archlab-sciencetokyo/robbit_project/robbit/setting/image/display-sim.png

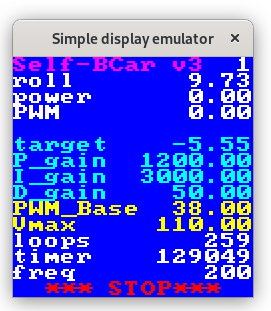
robbit/setting/image/display-sim.png
