archlab-sciencetokyo/robbit_project/robbit-esp/manual/robbit-esp_manual.pdf

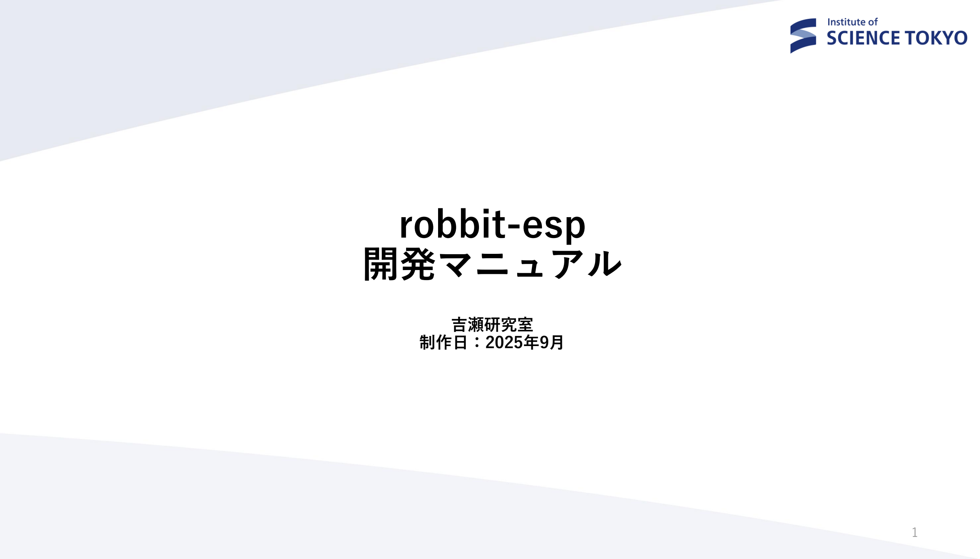
[picture p7: page 1]

## robbit-esp 開発マニュアル

吉瀬研究室
制作日：2025年9月

## robbit-esp : 概要

◼ robbit-espはESP32-C3で制御する扱いやすいtwo-wheeled self-balancing robotである。

◼ 開発手順
robbit-espの組み立て

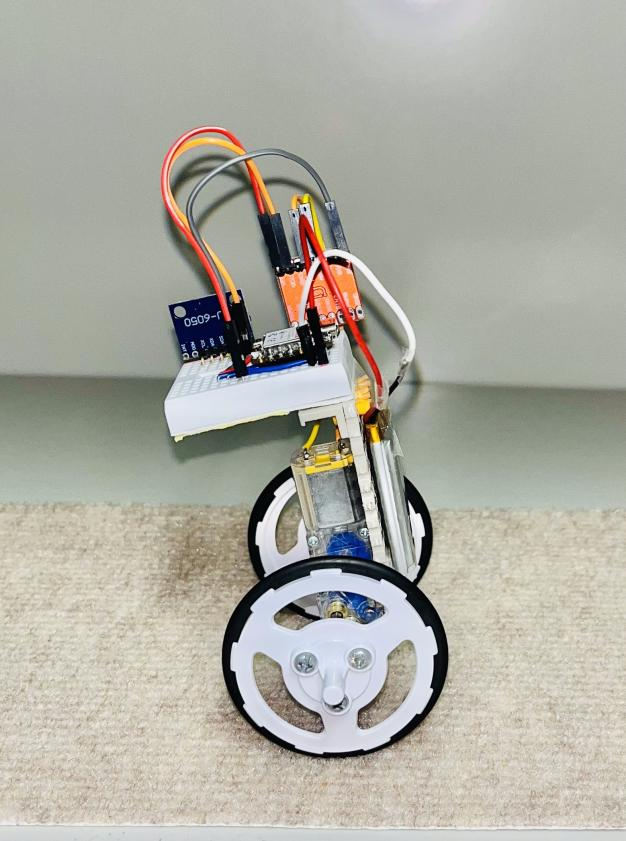
[picture p8: figure]
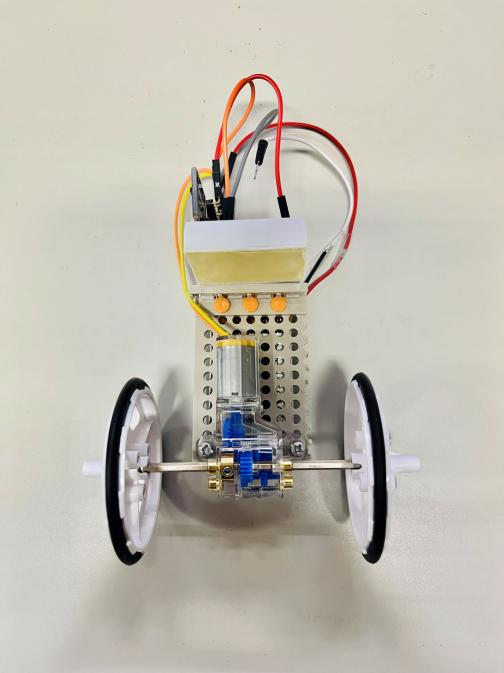
[picture p9: figure]

プログラム書き込み

動作確認

パラメータチューニング

robbit-esp

## robbit-espの組み立て : 部品購入

◼ robbit-espの組み立ては以下の手順で行う

部品購入 | シャーシ作成 | 制御ユニット作成 | 接着

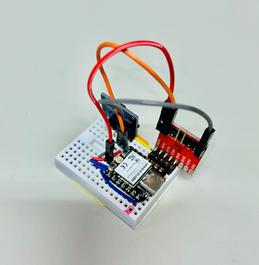
[picture p10: figure]
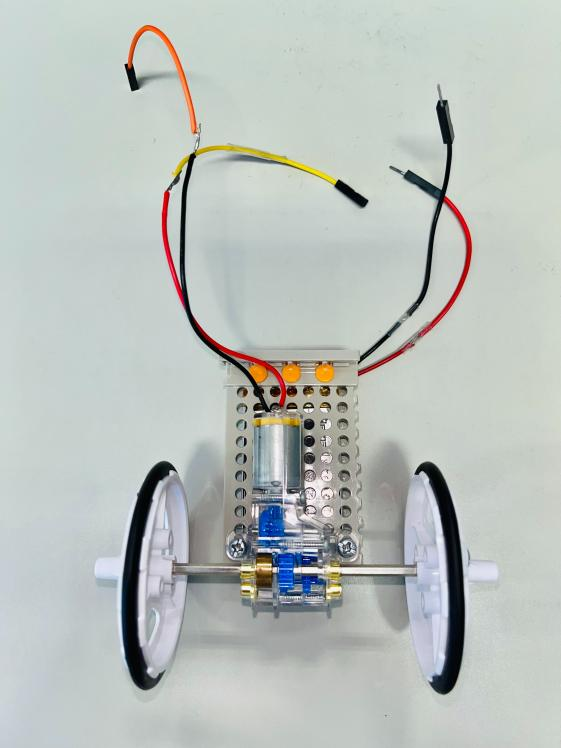
[picture p11: figure]

## robbit-espの組み立て : 部品購入

◼ 下記の部品一覧にある部品を購入する

部品 | 名称 | 個数
マイクロコントローラ | XIAO ESP32-C3 | 1
センサ | MPU-6050 | 1
モータ | Mini Motor Standard Gearbox 70188 | 1
タイヤ | Slim Tire Set (55mm Dia.) 70193 | 1
モータドライバ | TB6612FNG | 1
バッテリー | EEMB Lithium-Ion Battery 653042 | 1
プレート | Universal Plate Set 70157 | 1

## robbit-espの組み立て : シャーシ作成

◼ バッテリーと電源モジュールを図のようにはんだ付けする ◼ はんだ付け後は、バッテリーを充電モジュールに接続する ◼ 充電モジュールの色でバッテリーの充電具合がわかる (赤: 充電不足, 青: 充電完了)

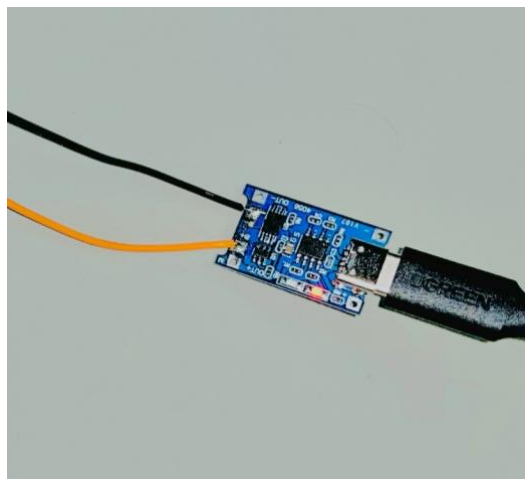
[picture p12: figure]
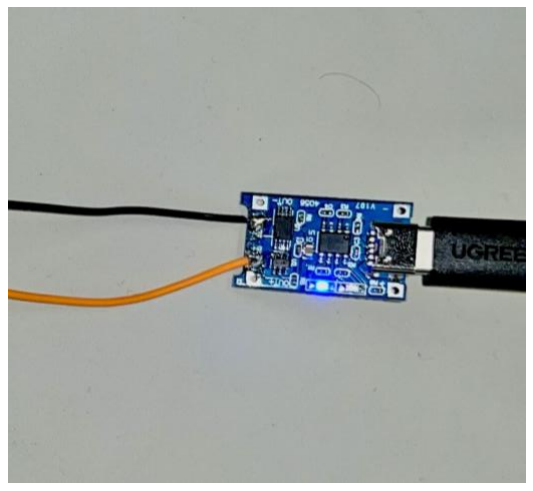
[picture p13: figure]

赤: 充電不足 | 青: 充電完了

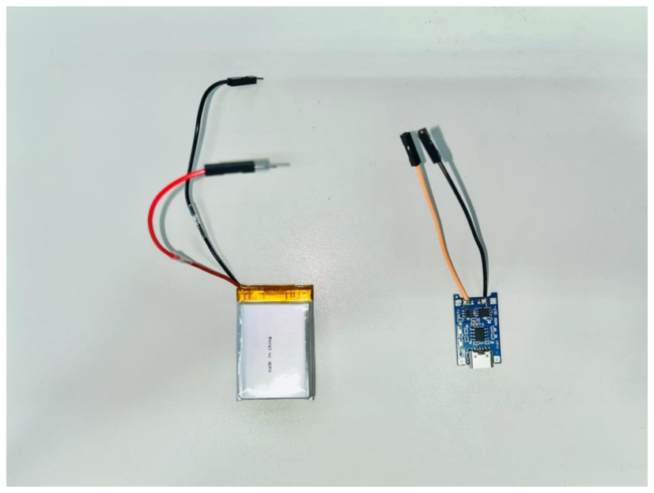
[picture p14: figure]

はんだ付けの例 | 充電モジュールのLED点灯

## robbit-espの組み立て : シャーシ作成

◼ ユニバーサルプレートをはんだ付けする
◼ ユニバーサルプレートはこの後作る制御ユニットの大きさに合わせるとよい ◼ またユニバーサルプレートには下図のように、制御ユニットを接着する部分を用 意しておく

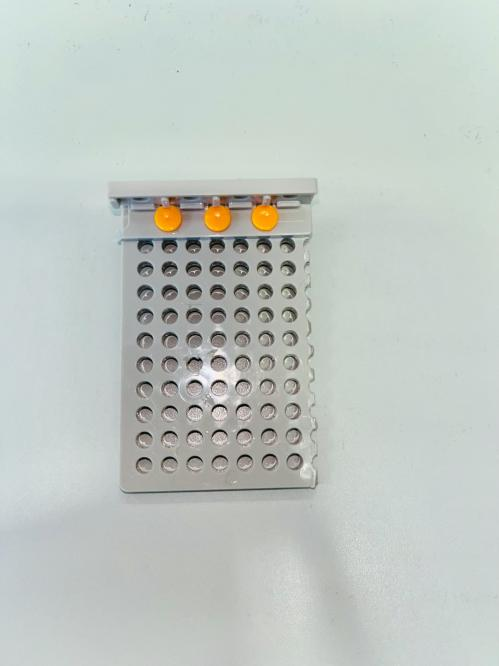
[picture p15: figure]
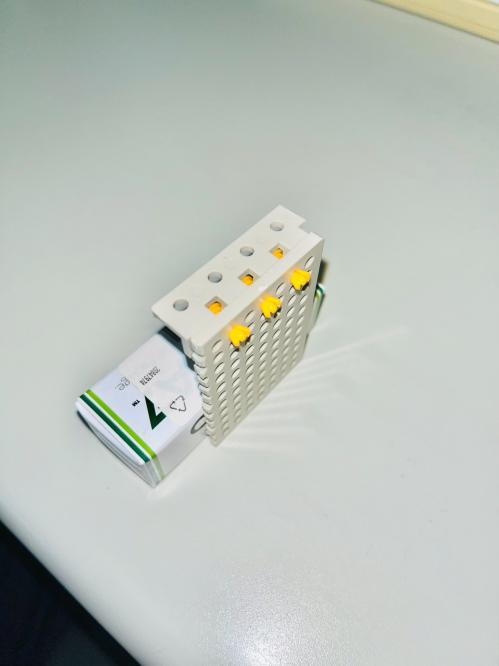
[picture p16: figure]

切断後のユニバーサルプレート | 制御ユニットとの接続部分 | 6

## robbit-espの組み立て : シャーシ作成

◼ TAMIYAのMini Motor Standard Gearbox 70188とSlim Tire Set (55mm Dia.) 70193を作成する。

◼ 次ページにギアボックス組み立てマニュアルを載せている。必要な部品や作業に は黄色で色付けしている

◼ タイヤに関しては、最初は直径が55mmのタイヤを使用すると良い。 直径が小さいタイヤも同封されているが、制御が難しくなる場合がある。

## robbit-espの組み立て : シャーシ作成

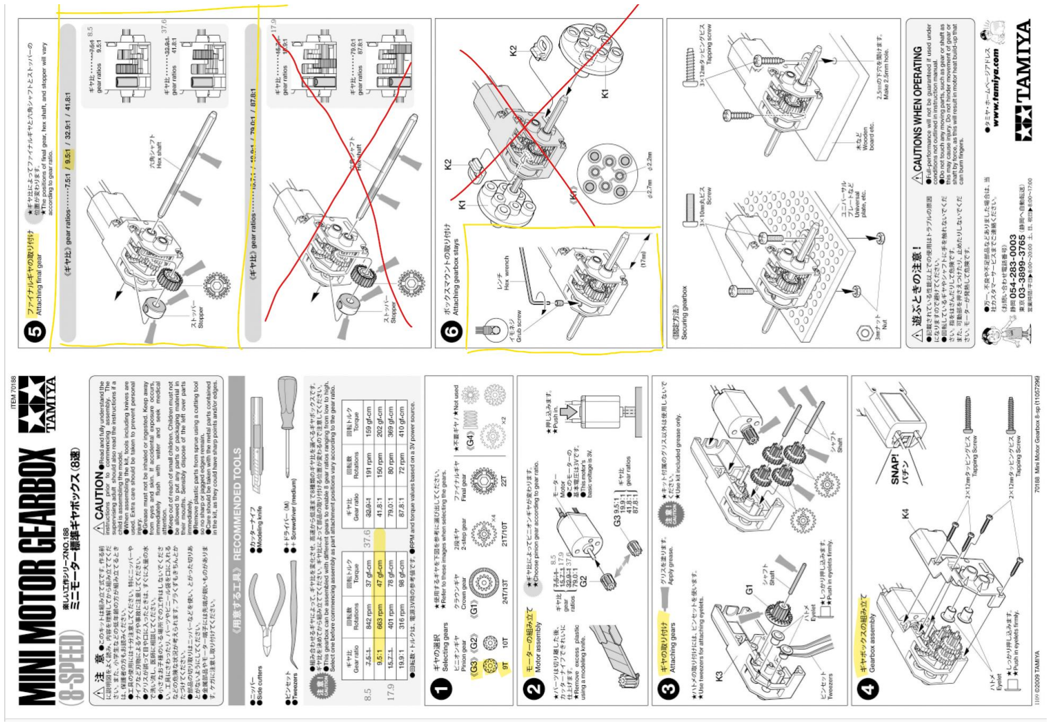
[picture p17: figure]

## robbit-espの組み立て : シャーシ作成

◼ モータが完成したらタイヤを取り付ける
◼ 最後にユニバーサルプレートにバッテリーとモータを取り付けるとシャーシが完 成する。

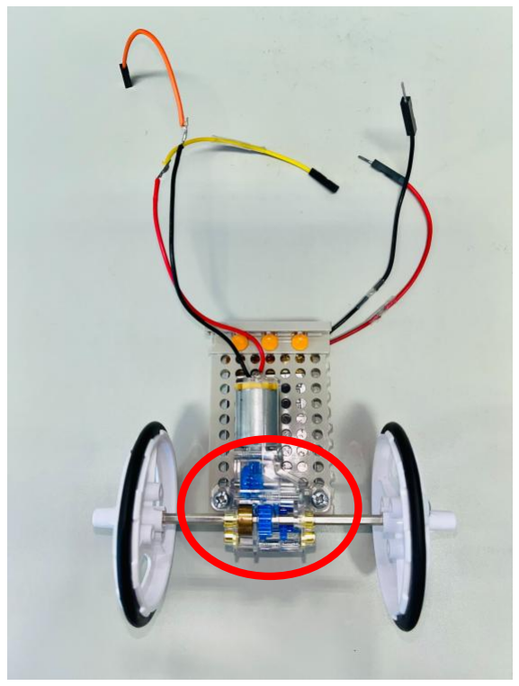
[picture p18: figure]
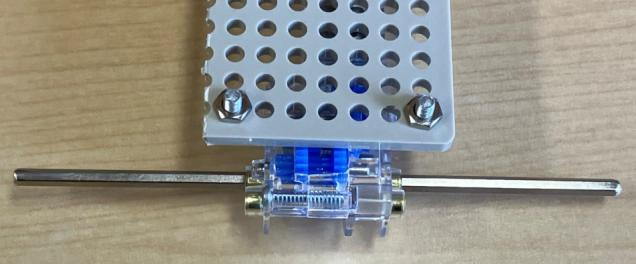
[picture p19: figure]

シャーシの完成例 | 9

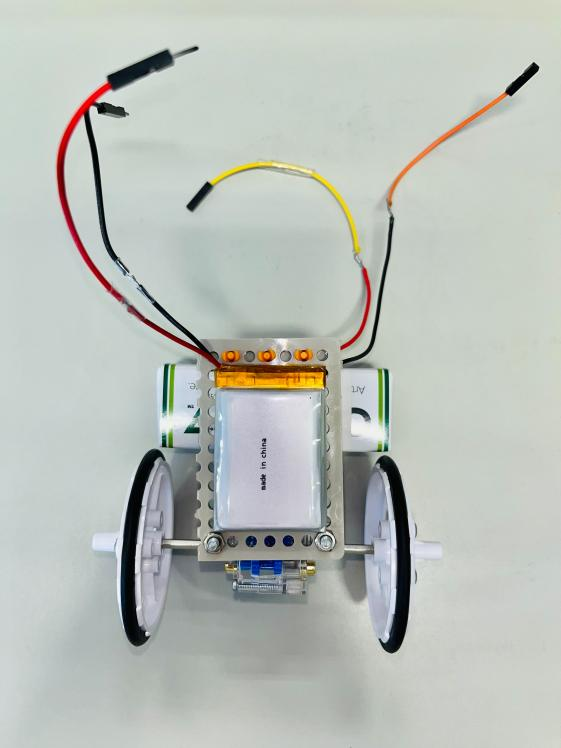
[picture p20: figure]

ネジでしっかり固定

## robbit-espの組み立て : 制御ユニット作成

◼ センサ(MPU-6050)にピンヘッダをはんだ付けする。 IMUモジュールはVCC, GND, SCL, SDAをつなげば動作するが，安定性向上のため接続部分にはすべて ヘッダピンをはんだ付けすることを勧める。

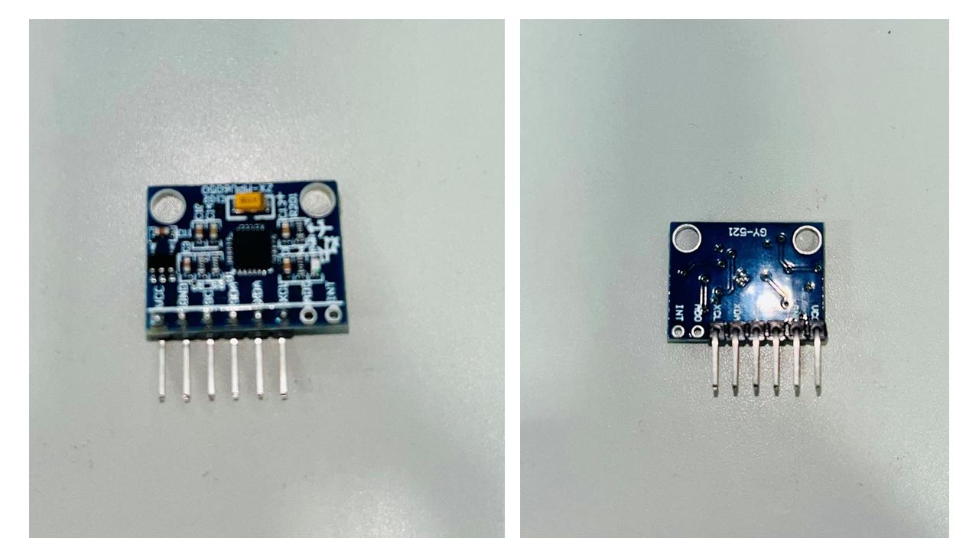
[picture p21: figure]
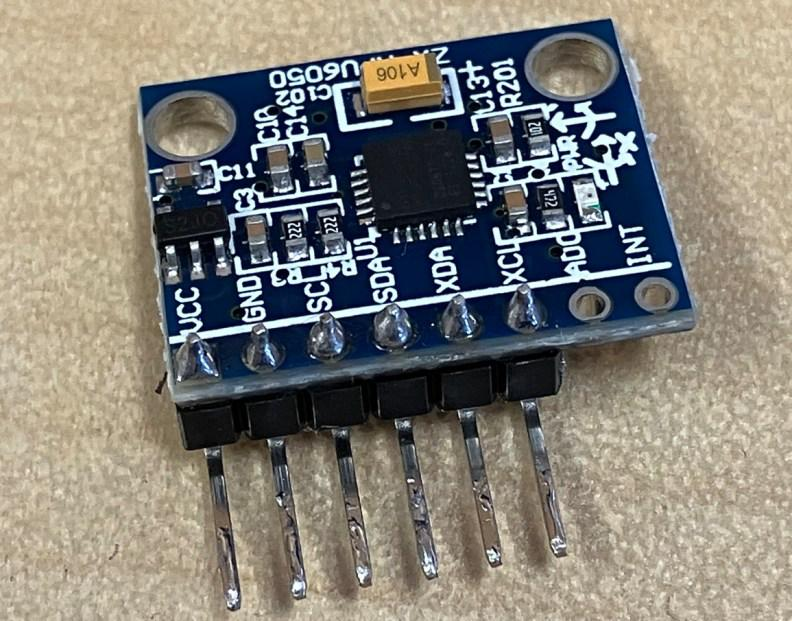
[picture p22: figure]

はんだ付けの例 | 10

## robbit-espの組み立て : 制御ユニット作成

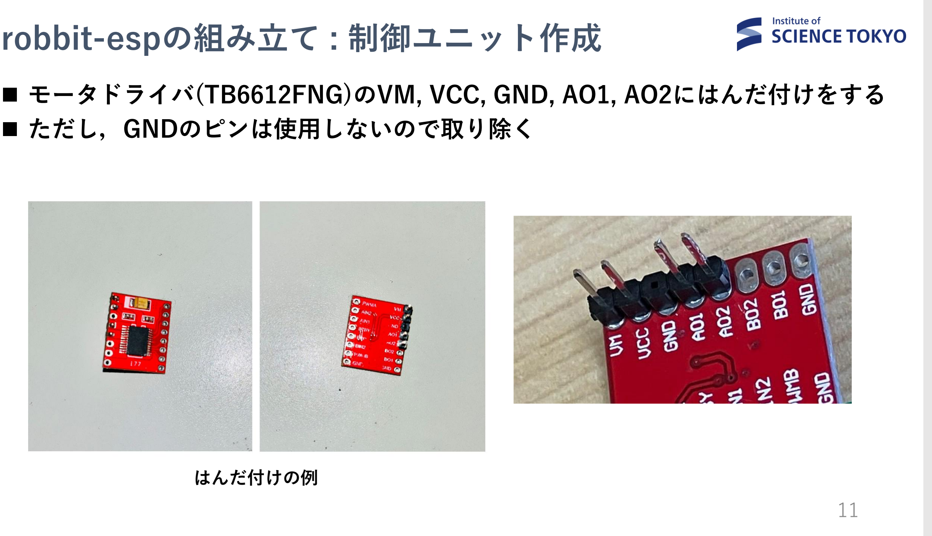
[picture p23: page 11]

◼ モータドライバ(TB6612FNG)のVM, VCC, GND, AO1, AO2にはんだ付けをする ◼ ただし，GNDのピンは使用しないので取り除く

はんだ付けの例

## robbit-espの組み立て : 制御ユニット作成

◼ ブレッドボードまたは、ユニバーサル基板を用意する。
◼ 用意したブレッドボードまたは基板に回路図を参考に配線、はんだ付けをする。

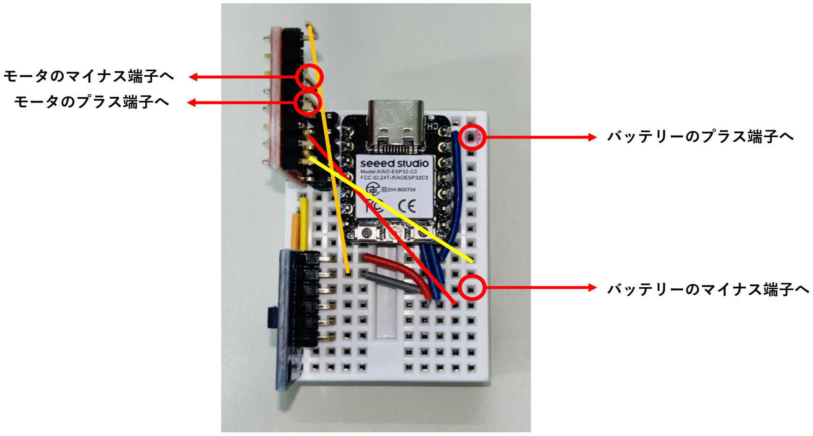
[picture p24: figure]
バッテリーのプラス端子へ; バッテリーのマイナス端子へ; モータのマイナス端子へ; モータのプラス端子へ
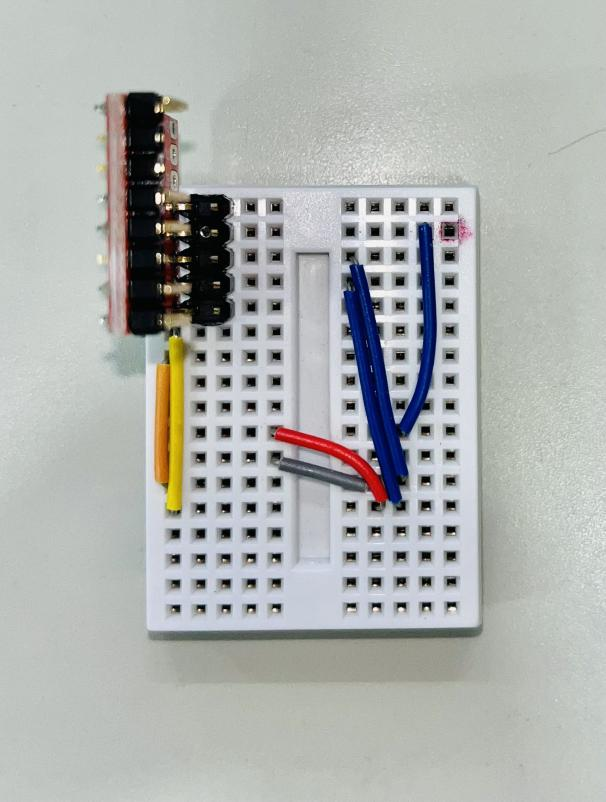
[picture p25: figure]

## robbit-espの組み立て : 制御ユニット作成

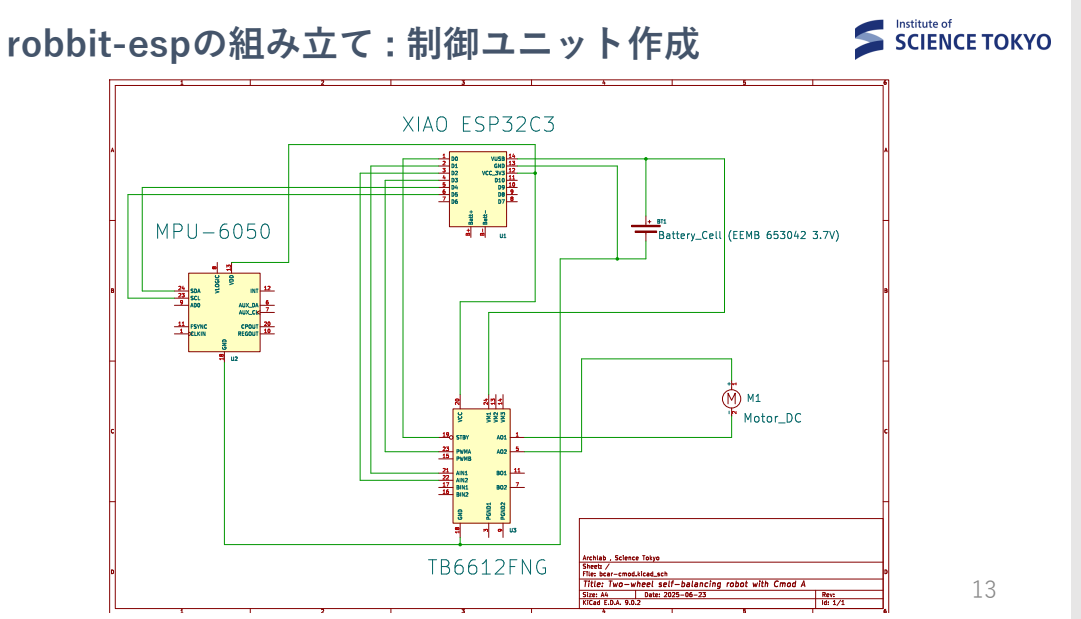
[picture p26: page 13]

## robbit-espの組み立て : 制御ユニット作成

◼ 完成したシャーシと制御ユニットを両面テープ等で接着すると、robbit-espが完 成する。

接着

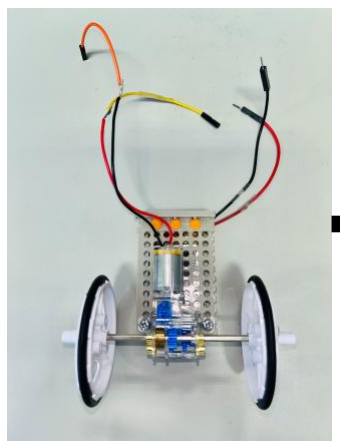
[picture p27: figure]

シャーシ

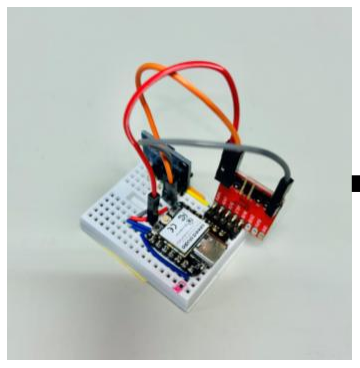
[picture p28: figure]

制御ユニット

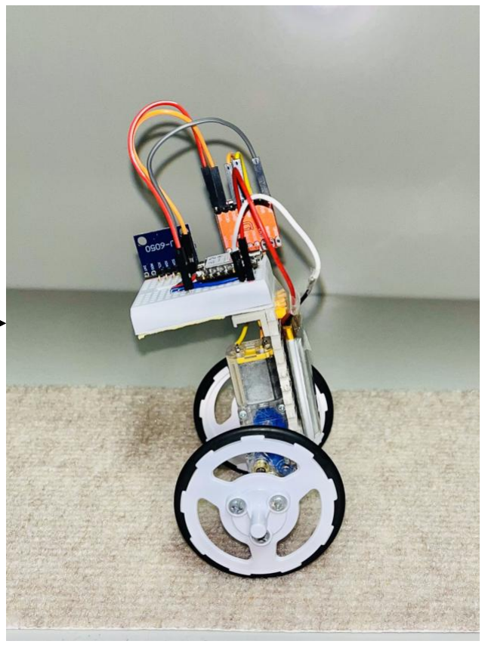
[picture p29: figure]

robbit-esp

## プログラム書き込み: 環境構築

◼ 完成したrobbit-espにプログラムを書き込むにはArduino IDEを使用する ダウンロードしていない場合はダウンロードする

◼ ダウンロードページ: https://www.arduino.cc/en/software/

◼ Arduino IDEのダウンロードが完了したら、githubのリポジトリにあるrobbit-esp.inoを開き、各種設定を行う。

## プログラム書き込み: ボード設定

◼ `File` -> `Preferences` -> `Setting` -> `Additional boards manager URLs` に以下のURLを設定する
https://raw.githubusercontent.com/espressif/arduino-esp32/gh-pages/package_esp32_index.json

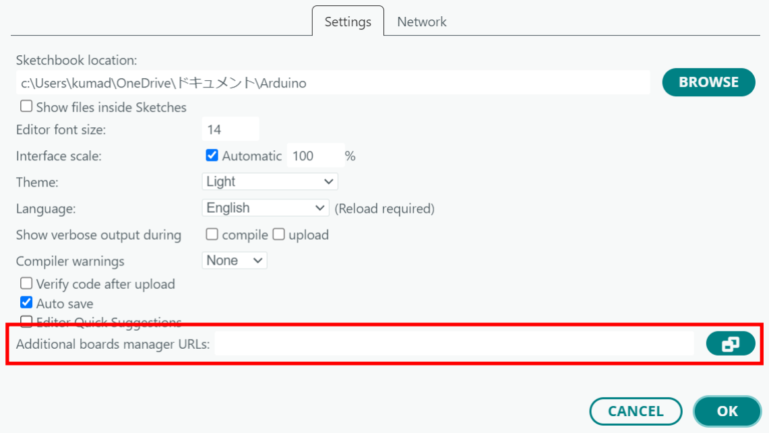
[picture p30: figure]

URLの記入場所

## プログラム書き込み: ボード設定

◼ `Tools` -> `Board` -> `Board Manager`でBoard Managerを開き `esp32 by Espressif Systems`をダウンロードする
◼ `Tools` -> `Board` -> `esp32` -> `XIAO_ESP32C3` を選択する
◼ `Tools` -> `Port` でESP32-C3に対応するポート番号を設定する

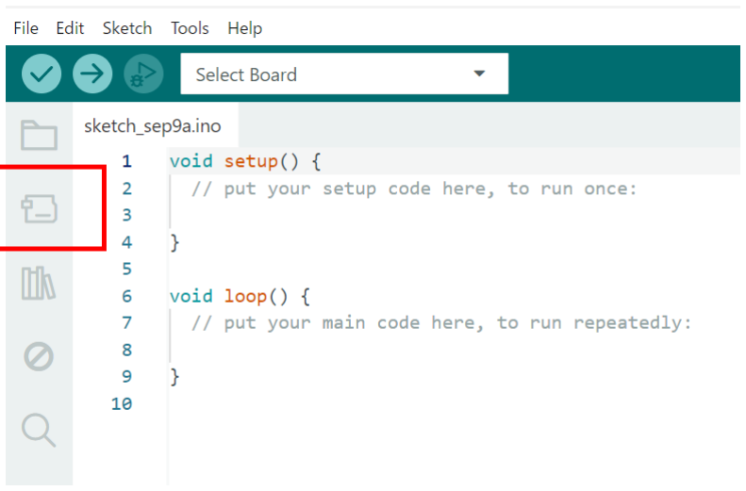
[picture p31: figure]

ここからもボードマ
ネージャーを開ける

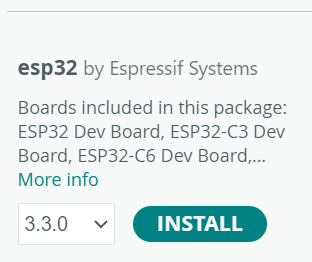
[picture p32: figure]

インストールするボード

## プログラム書き込み: ライブラリ設定

◼ `Tools` -> `Manage libraries`でライブラリマネージャーを開き以下のライブ ラリをインストールする

- MPU6050 by Electric Cats
- Madgwick by Arduino
- BluetoothSerial by Henry Abrahamsen

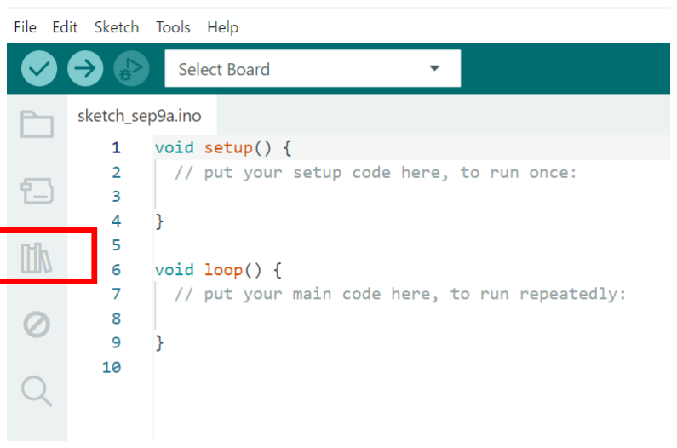
[picture p33: figure]

◼ Madgwickフィルタのライブラリ内にMadgwickAHRS.hというヘッダーファイ ルがあるので以下の関数を追加する

void setGain(float gain) { beta = gain; }

ここからもライブラリ
マネージャーを開ける

## プログラム書き込み: 書き込み

◼ 書き込む前に以下のことを確認する
- PCとESP32-C3が接続する
- `Tools` -> `Port` でESP32-C3に対応するポート番号を設定する
- `Tools` -> `Board` -> `esp32` -> `XIAO_ESP32C3` を選択する

◼ 上記の内容をすべて確認出来たら画面左上のUploadマークを押すとコンパイルが 行われた後、書き込みが行われる。

Uploadボタン

## 動作確認

◼ 書き込みが終了したら、PCとESP32-C3の接続を解除し、robbit-espの電源を入 れて動作を確認する。
◼ 動作確認はカーペットのようなある程度摩擦が生じる環境で行うと良い。
◼ 摩擦のない環境だと、その場で自立することが難しくなる。

動作確認の項目
◼ 手にもって、robbit-espを傾けた時に傾けた方向に車輪が回転するか
◼ 垂直状態から90度傾けた時に車輪の動きが止まるか(プログラムでは40度傾くと 止まるようになっている)

## パラメータチューニング: 環境構築

◼ robbit-espはPCやスマートフォンとのBLE通信によりパラメータチューニングを 行える。

◼ PCの場合
- パラメータチューニングにはpythonライブラリのbleakを使用するため、仮想環 境を作成する必要がある
- Pythonの仮想環境を作成した後、pip install bleakを実行しインストールを行う -> 22ページへ
◼ スマートフォンの場合
- BLE通信を行う専用のアプリをインストールする -> 25ページへ

BLE Scanner(Android, iOS両方に対応)

## パラメータチューニング: BLE接続(PC)

◼ robbit-espを起動し、少し待ってからble_connect.pyを実行する。
◼ 実行すると、robbit-espとPCの無線での接続が行われ、成功すると下記の画面が 出力される。
◼ この画面では，robbitに搭載するESP32-C3のサービスUUID(Service_uuid)、 MACアドレス(MAC_adress)、Characteristic_uuidを表示している。
◼ Service_uuidとCharacteristic_uuidはinoファイルの冒頭で定義している値に なっているはずである。

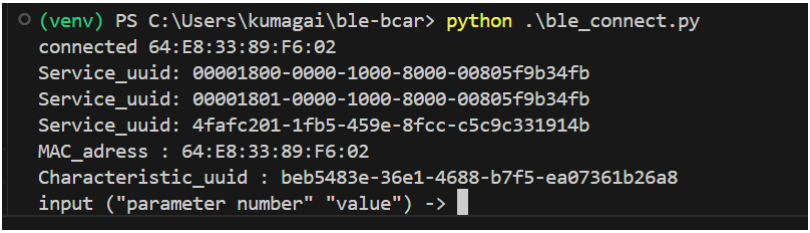
[picture p34: figure]

## パラメータチューニング: 値変更(PC)

◼ パラメータの変更は`input (“parameter number” “value”) -> `の後に以下のよ うな形式で入力すると実行される。パラメータ番号については28ページ参照

"パラメータ番号"␣"値"
ただし、␣は半角スペース

◼ 下の画像はV_MAXというパラメータを200に変更した場合の例である。 変更が完了すると、変更結果が出力される

## パラメータチューニング: その他の命令

◼ 現状のパラメータを確認したい場合は、`input ("parameter number" "value") -> `に`r`を入力すると確認できる。

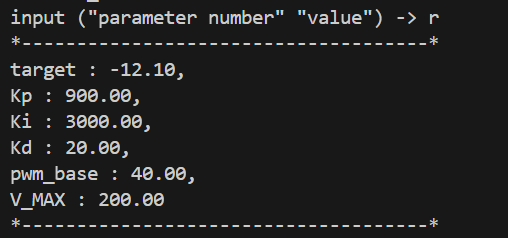
[picture p35: figure]

◼ robbit-espとのBLE接続を解除する場合には，`input (“parameter number” “value”) -> `に`e`を入力すると解除できる。

## パラメータチューニング: BLE接続(スマホ)

◼ robbit-espを起動すると、BLE Scannerの画面 にESP32-C3の接続先が現れる
◼ 接続端末の名前はinoファイル内の以下の部分で
設定している
◼ 同時に複数のrobbit-espを動かす際には、それぞ れ接続端末の名前を変更することを勧める

接続端末の名前設定

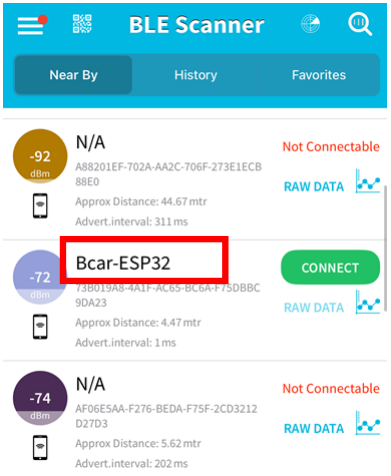
[picture p36: figure]

アプリの画面

## パラメータチューニング: 値変更(スマホ)

◼ パラメータの変更は以下のような形式で入力すると実行される。 パラメータ番号については28ページ参照

"パラメータ番号"␣"値"
ただし、␣は半角スペース

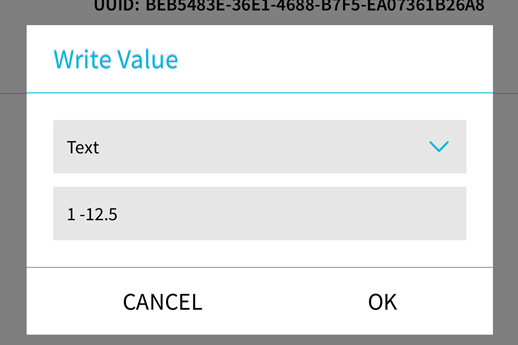
[picture p37: figure]

入力例

## パラメータチューニング: その他の命令

◼ アプリ内でread処理を行うことですべてのパラメータを確認できる ◼ 表示形式はカンマ区切りで以下のように出力される。 TARGET, P_GAIN, I_GAIN, D_GAIN, PWM_Base, V_MAX

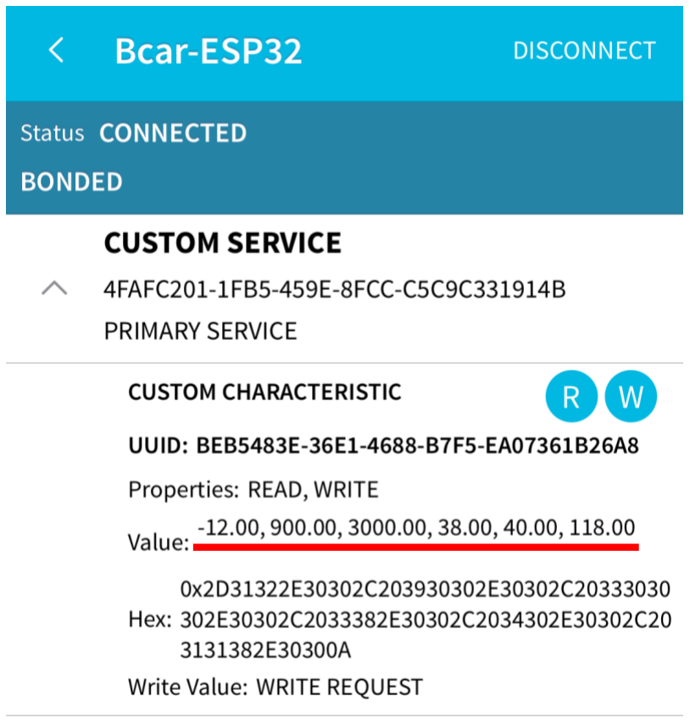
[picture p38: figure]

パラメーター値

## パラメータチューニング: パラメータ番号

◼ パラメータチューニングの際に利用するパラメータ番号とは、変更可能なパラ メータに割り当てられている番号である

パラメータ名 | パラメータ番号 | 役割
Target | 1 | 車体の目標角度
P_gain | 2 | 比例要素のゲイン
I_gain | 3 | 積分要素のゲイン
D_gain | 4 | 微分要素のゲイン
PWM_Base | 5 | PWM信号の増加値
V_max | 6 | PWM信号の最大値

## パラメータチューニング: その他のパラメータ

- ループ周波数
ループ周波数とはrobbit-esp.ino内に記述されているwhileループの周波数を表す robbit-esp.ino内の``D_LOOP_HZ`がループ周波数を表す 値を大きくすればその分whileループ内の処理も高速に行われる 単位はHzで記述する
- 積分要素の上限値
アンチワインドアップ実装のため，積分要素の上限値を決定する robbit-esp.inoの`D_I_MAX`に値が設定してある

500Hzに設定した例

上限値を0.2に設定した例

## 問題設定

パラメータチューニングの際にどの程度まで性能向上を目指すか、目標を考える 下記は一例である

◼ 難易度：易しい
カーペットなどの摩擦のある領域で10分以上の自立を目指す

◼ 難易度：難しい
摩擦の少ない領域でできるだけ長く自立させる
風や傾斜などの外乱を加える
