archlab-sciencetokyo/robbit_project/robbit-esp/manual/robbit-esp_system_manual.pdf

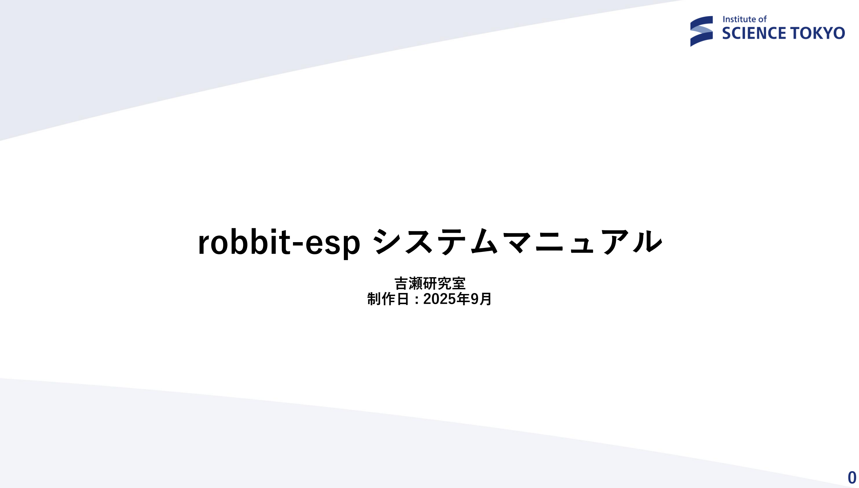
[picture p45: page 1]

## robbit-esp システムマニュアル

0

吉瀬研究室
制作日 : 2025年9月

概要

◼ このプログラムはrobbit-espのハードウェア，ソフトウェアの内容を説明してい る

◼ この資料を参考にすることで，robbit-espのシステムの理解が容易になり，性能 改善を行いやすくなる

1

## robbit-esp : ハードウェア

2

◼ マイコンボード: XIAO ESP32-C3
◼ センサ: MPU-6050(IMU)
- 加速度，角速度(ジャイロ)センサ
◼ ギアモータ: ミニモータ標準ギヤボックス(TAMIYA)

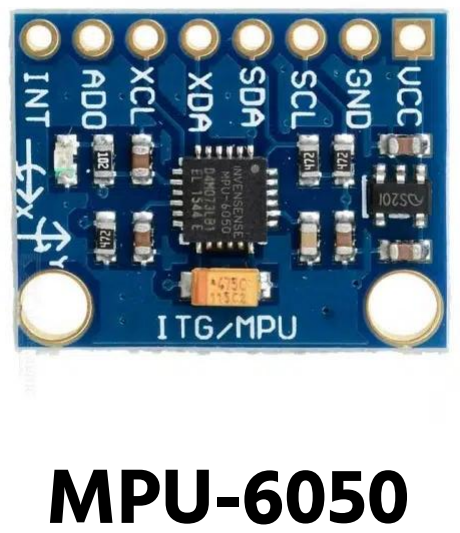
[picture p46: figure]
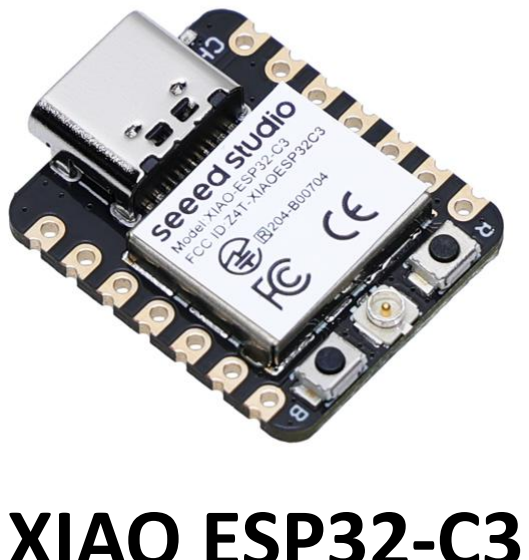
[picture p47: figure]
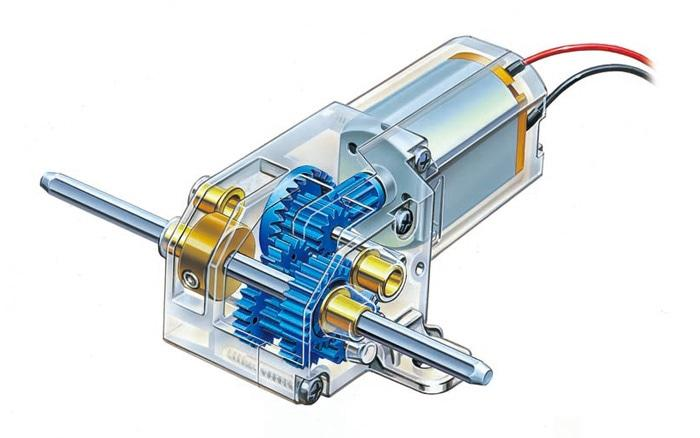
[picture p48: figure]

XIAO ESP32-C3 | MPU-6050 | ミニモータ標準ギヤボックス(TAMIYA)

## robbit-esp : ハードウェア

3

◼ モータドライバ: TB6612FNG搭載 モータドライバ ◼ タイヤ:スリムタイヤセット(55mm 径) 70193 ◼ バッテリー: EEMB 653042(3.7V)

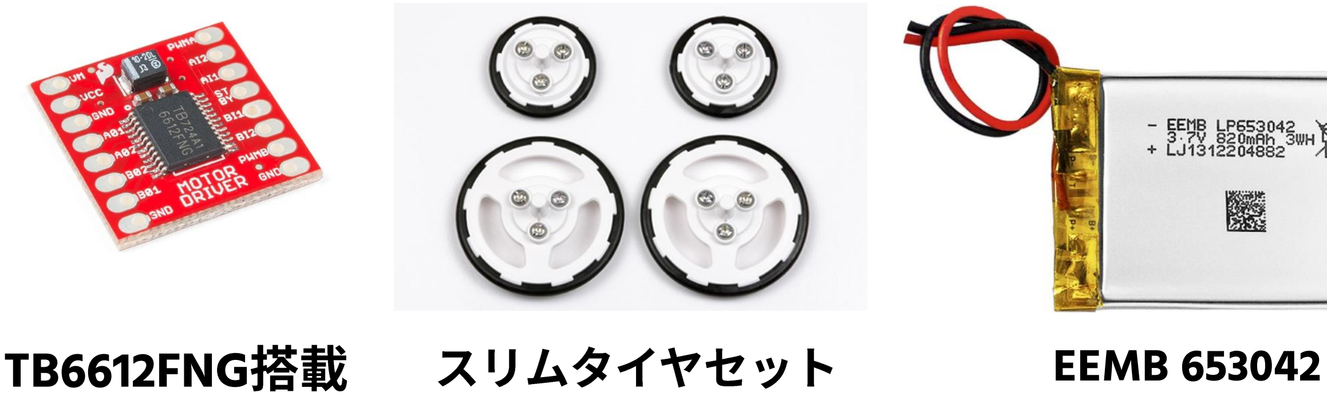
[picture p49: figure]
TB6612FNG搭載; スリムタイヤセット; EEMB 653042

モータドライバ

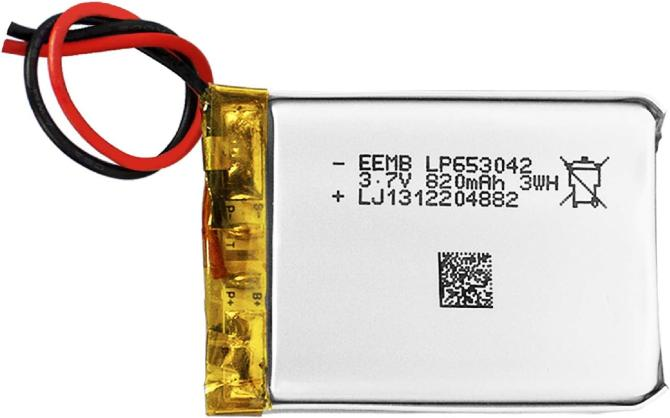
[picture p50: figure]

充電式バッテリー

## ソフトウェア: 概要

ソフトウェア処理はrobbit-esp.inoに書いてある。以下にフローチャートを示す。

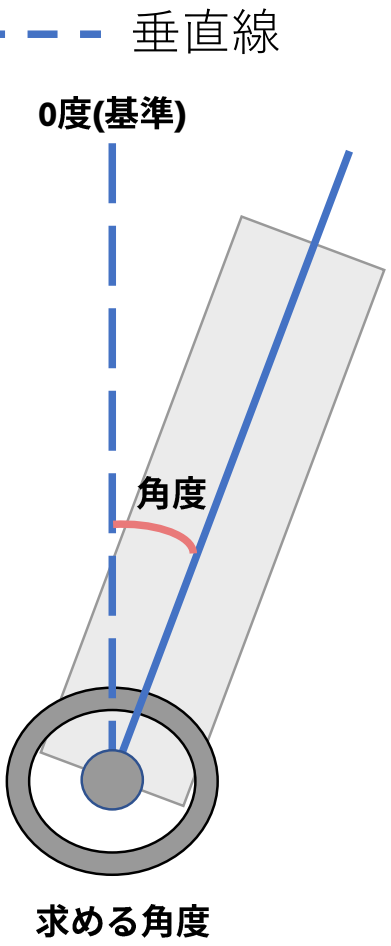
[picture p51: figure]
垂直線; 求める角度

4

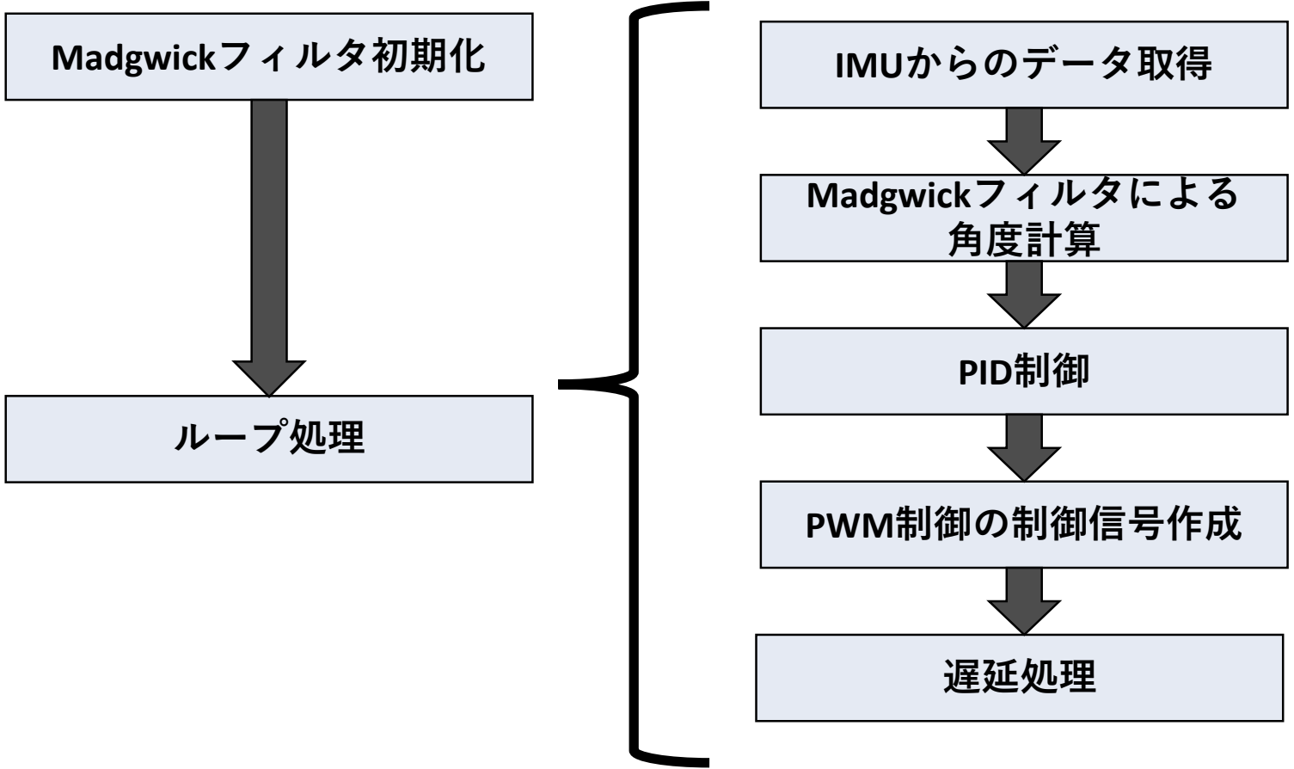
[picture p52: figure]
Madgwickフィルタ初期化; IMUからのデータ取得; Madgwickフィルタによる 角度計算; PID制御; PWM制御の制御信号作成; 遅延処理; ループ処理

## ソフトウェア: IMUからのデータ取得

◼ IMUから3軸の加速度と角速度を取得する
◼ IMUとの通信には既存のライブラリを用いる

◼ 3軸の加速度と角速度とMadgwickフィルタを利用することで角度を算出する ◼ (https://github.com/arduino-libraries/MadgwickAHRS) Madgwick (https://github.com/arduino-libraries/MadgwickAHRS)フィルタのライブラリにゲインの調整機能を追加して実装する (https://github.com/arduino-libraries/MadgwickAHRS)

5

## ソフトウェア: PID制御

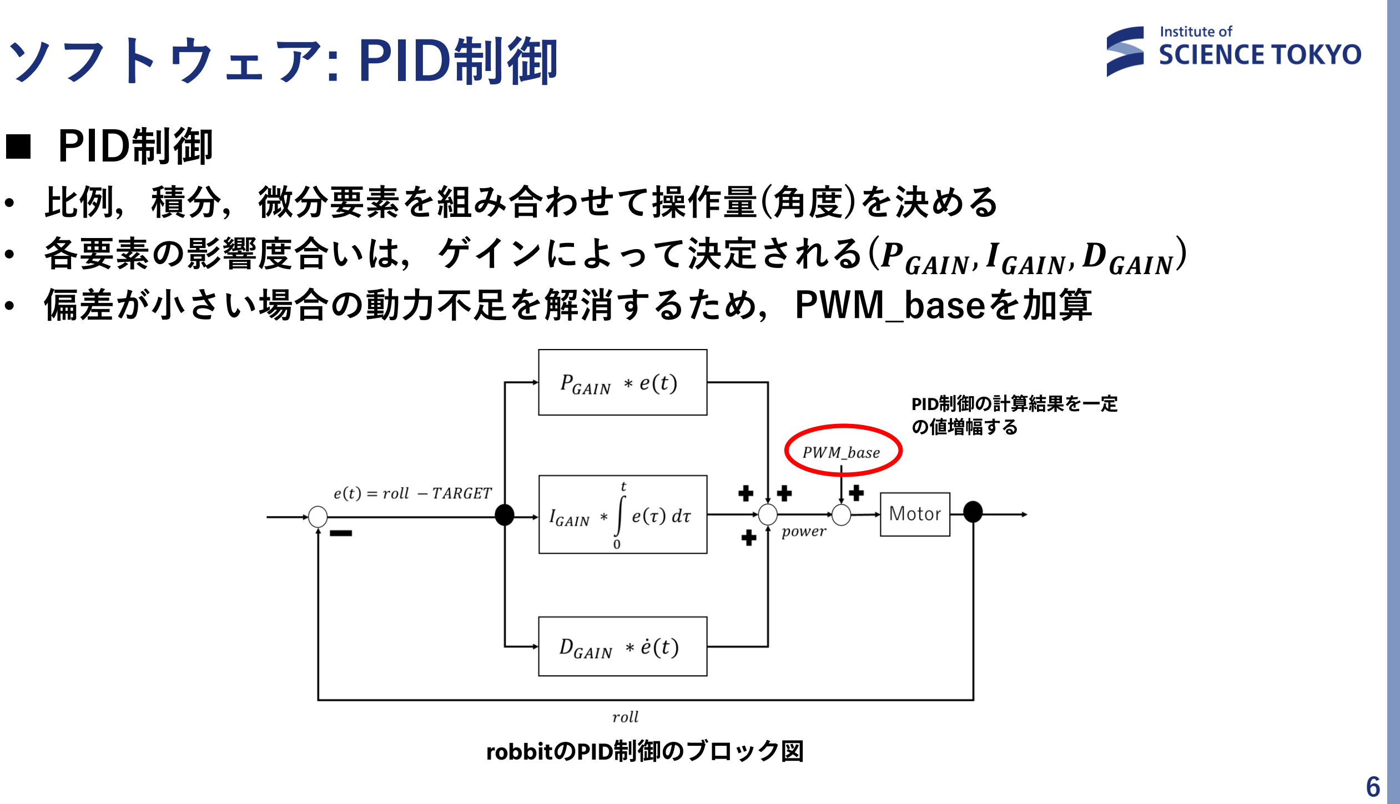
[picture p53: page 7]

◼ PID制御
- 比例，積分，微分要素を組み合わせて操作量(角度)を決める
- 各要素の影響度合いは，ゲインによって決定される(PGAIN, IGAIN, DGAIN)
- 偏差が小さい場合の動力不足を解消するため，PWM_baseを加算

6

robbitのPID制御のブロック図

PID制御の計算結果を一定
の値増幅する

## PID制御: 比例要素(P成分)

◼ 比例要素は操作量と目標値の誤差で表される
◼ PGAINが大きいと，偏差に対して敏感に反応する

7

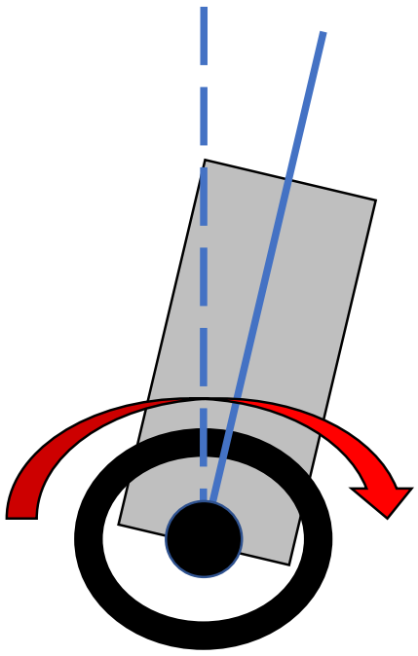
[picture p54: figure]
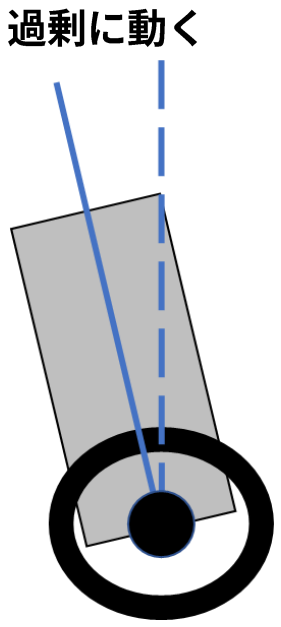
[picture p55: figure]
過剰に動く

比例要素の反映

PGAINが小さい

PGAINが適切

安定する

PGAINが大きい

robbit-espの現在角度

目標角度

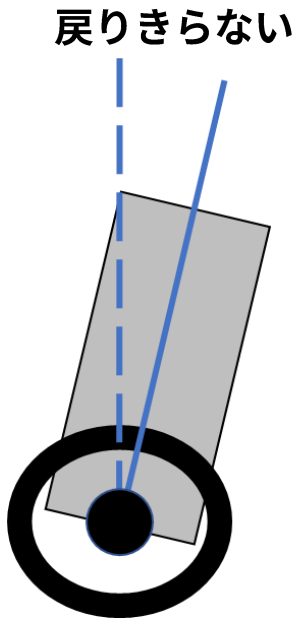
[picture p56: figure]
戻りきらない

比例要素の影響によるrobbitの動作イメージ

## PID制御: 積分要素(I成分)

◼ 積分要素は操作量と目標値の誤差を時間積分している
◼ IGAINを大きくすると偏差を小さくできるが，大きすぎるとI成分の蓄積が大 きくなり，システムの速応性や安定性が悪くなる

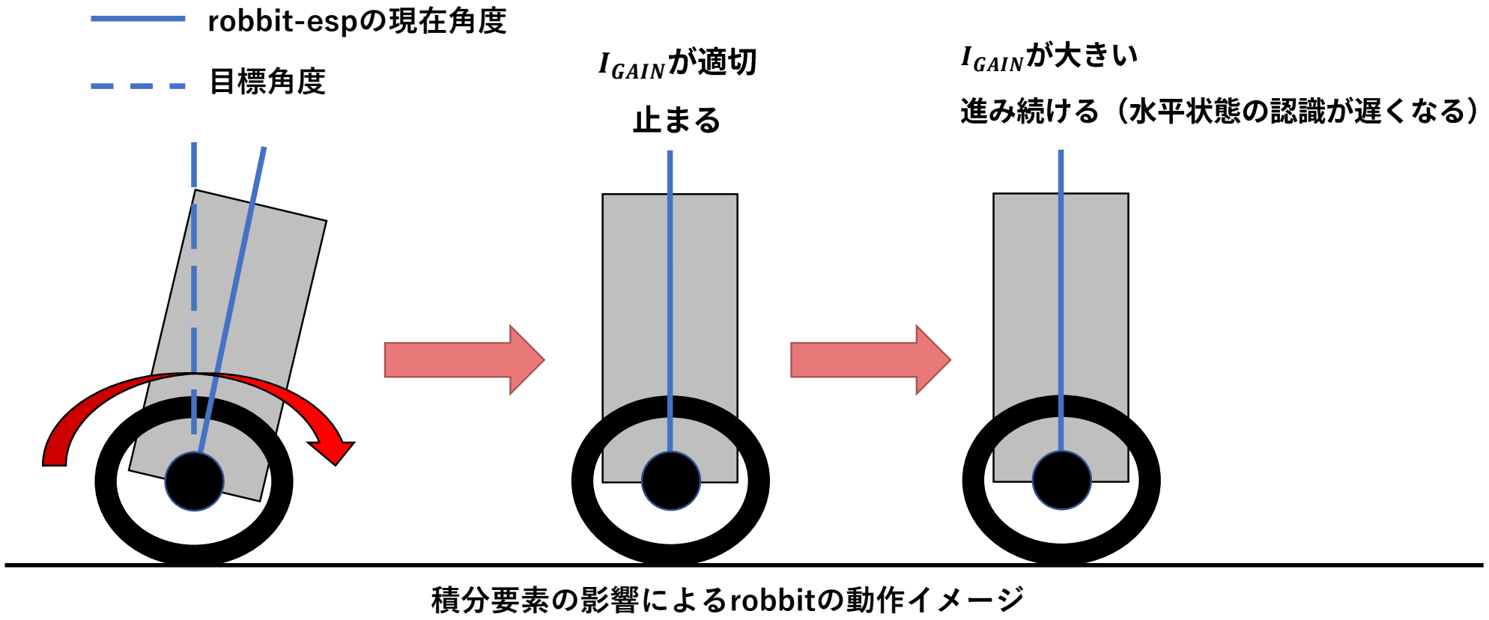
[picture p57: figure]
robbit-espの現在角度; 目標角度; 積分要素の影響によるrobbitの動作イメージ; IGAINが適切; 止まる; IGAINが大きい; 進み続ける（水平状態の認識が遅くなる）

8

## PID制御: アンチワインドアップ

◼ 前ページで述べた積分要素の蓄積を抑える手段としてアンチワインドアップが存 在する
◼ 実装方法は，積分要素の計算結果に対して上限と下限を設定し，範囲内だったら 積分要素の値を更新する

I = ቐ
IMAX | ( | I + P ∗ dt | > I_MAX)
−IMAX | ( | I + P ∗ dt | > I_MAX)
I + P ∗ dt | else

9

## PID制御: 微分要素(D成分)

◼ 微分要素は操作量と目標値の誤差を時間微分している
◼ DGAINを大きくすると，目標角度を行き過ぎるオーバーシュートが抑制され る。大きすぎると目標角度に到達する時間が長くなる。

10

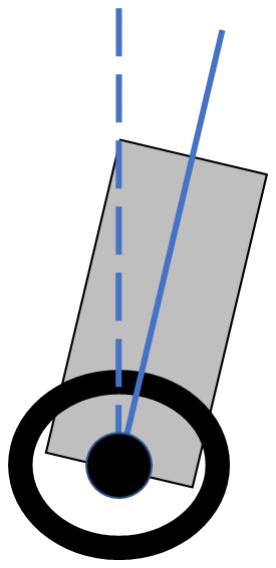
[picture p58: figure]

robbit-espの現在角度

目標角度

微分要素の影響によるrobbitの動作イメージ

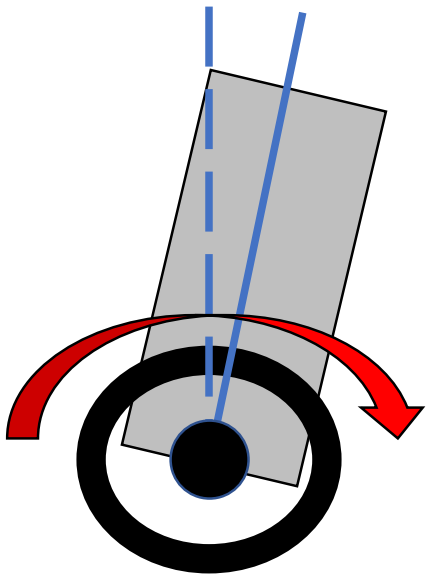
[picture p59: figure]

DGAINが適切

DGAINが大きい

t秒後

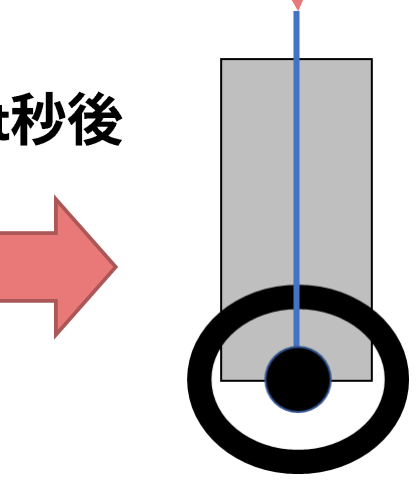
[picture p60: figure]

t秒後 | t秒後

目標角度に達するまで
の時間差が生まれる

## ソフトウェア: PID制御

PID制御の実装は以下の通り

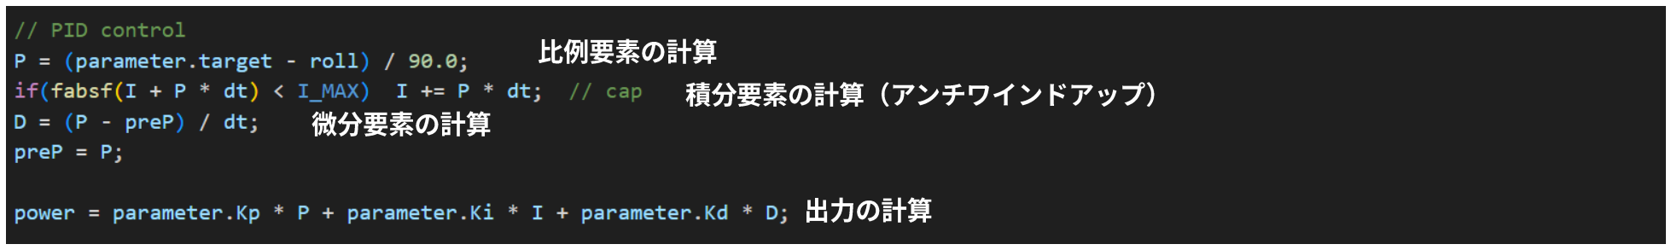
[picture p61: figure]
比例要素の計算; 積分要素の計算（アンチワインドアップ）; 微分要素の計算; 出力の計算

◼ 変数Pでは比例要素を計算するため，目標角度(TARGET)と現在角度(roll)の偏差 を導出する
◼ 変数Iでは積分要素を求めるため，比例要素を長方形近似で積分している If(fabsf(I+P*dt))の部分がアンチワインドアップの条件式に該当する
◼ 変数Dでは微分要素を求めるため，微分の公式を用いて計算を行っている ◼ 最後にpowerにすべての要素の値を足し合わせることで出力を計算する

11

## ソフトウェア: PWM信号の決定

PWM制御の制御信号として，波形がHIGHの割合をPWMbaseからVmaxで表現する 式で表すと以下の通りである
powerはPID制御の計算結果を表し， pwmbaseはPWM信号の増加分を表す

PWM = ቊ
power + PWMbase | power | < VMAX
VMAX | power | ≥ VMAX

また，powerの符号はモータの回転方向を決める制御信号として使われる

12

## ソフトウェア: BLE通信

◼ PCとrobbit-espのBLE接続は既存のライブラリを用いて行う (https://github.com/hen1227/bluetooth-serial)
◼ PCからの書き込み要求と読み込み要求が来た時に，非同期にデータの送受信を行 うため，コールバック関数として実装する

13

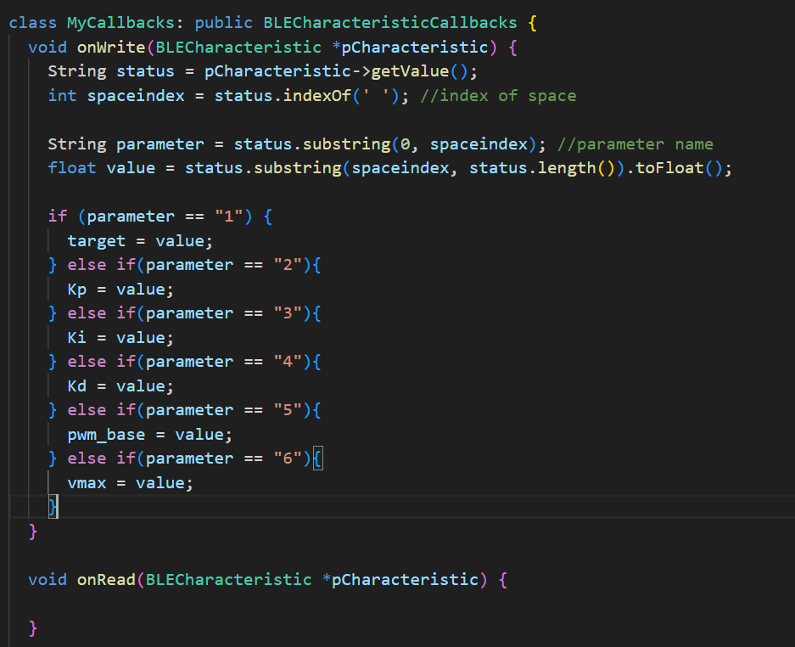
[picture p62: figure]

コールバック関数の処理

・ onWrite : PCからの書き込み要求に対応する関数

・ onRead : PCからの読み込み要求に対応する関数
