archlab-sciencetokyo/robbit_project/robbit-esp/manual/robbit-esp_system_manual_en.pdf

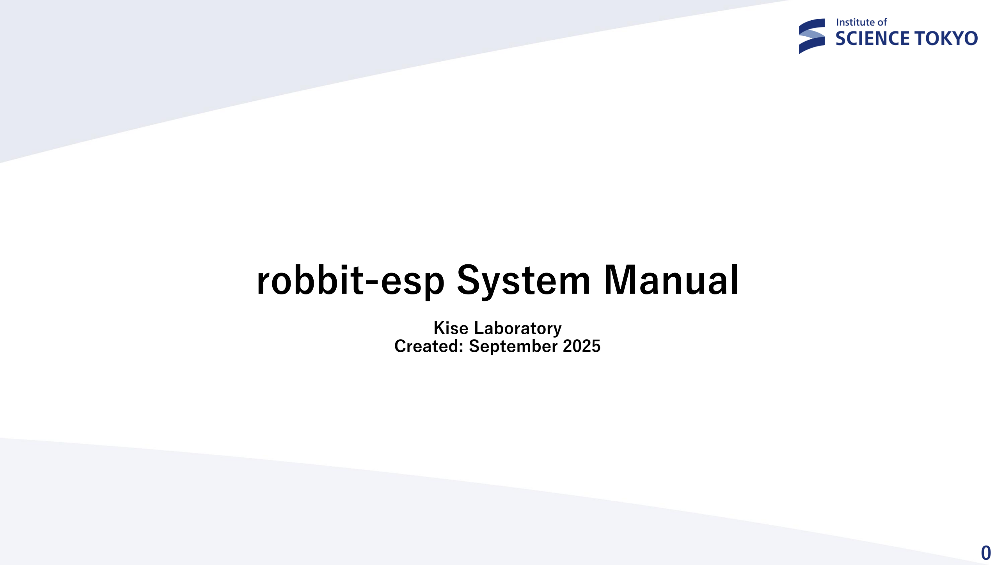
[picture p63: page 1]

## robbit-esp System Manual

0

Kise Laboratory
Created: September 2025

## Overview

◼ This manual describes the hardware and software of robbit-esp.

◼ This manual helps readers understand the robbit-esp system and improve its performance.

1

## robbit-esp: Hardware

2

◼ Microcontroller board: XIAO ESP32-C3
◼ Sensor: MPU-6050 (IMU)
- Accelerometer and angular-velocity (gyroscope) sensor
◼ Geared motor: Mini Motor Standard Gearbox (TAMIYA)


XIAO ESP32-C3 | MPU-6050 | Mini Motor Standard Gearbox (TAMIYA)

## robbit-esp: Hardware

3

◼ Motor driver: TB6612FNG motor-driver module ◼ Tires: Slim Tire Set (55 mm diameter), 70193 ◼ Battery: EEMB 653042 (3.7 V)

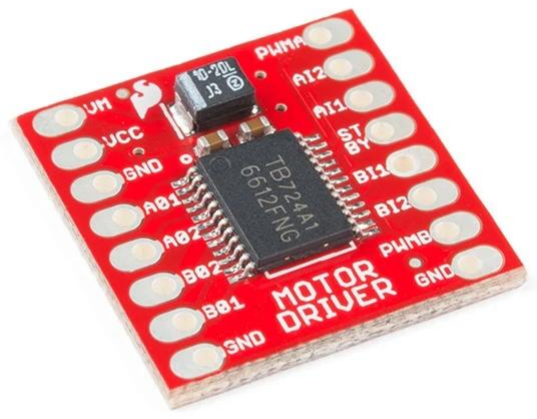
[picture p64: figure]

## TB6612FNG Motor Driver

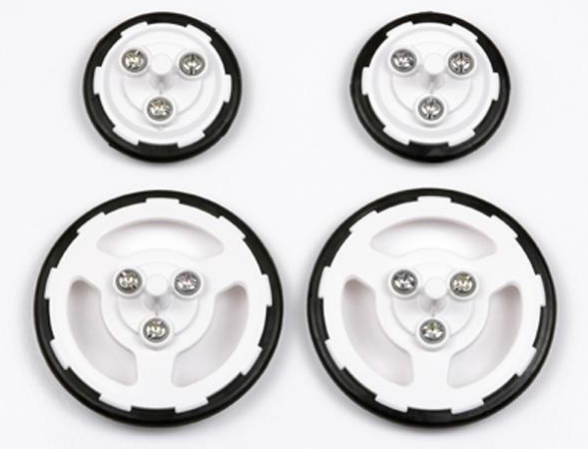
[picture p65: figure]

Slim Tire Set | EEMB 653042 Rechargeable Battery

## Software: Overview

The software is implemented in robbit-esp.ino. The processing flow is shown

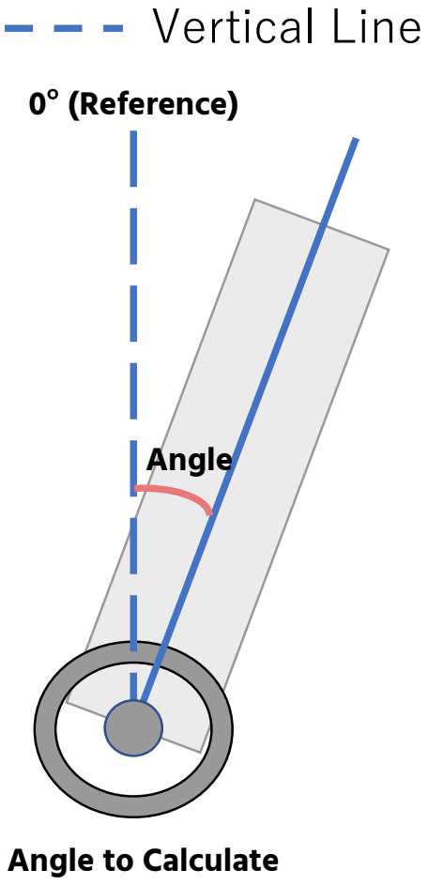
[picture p66: figure]
Vertical Line; Angle to Calculate; Angle; 0°(Reference)

4

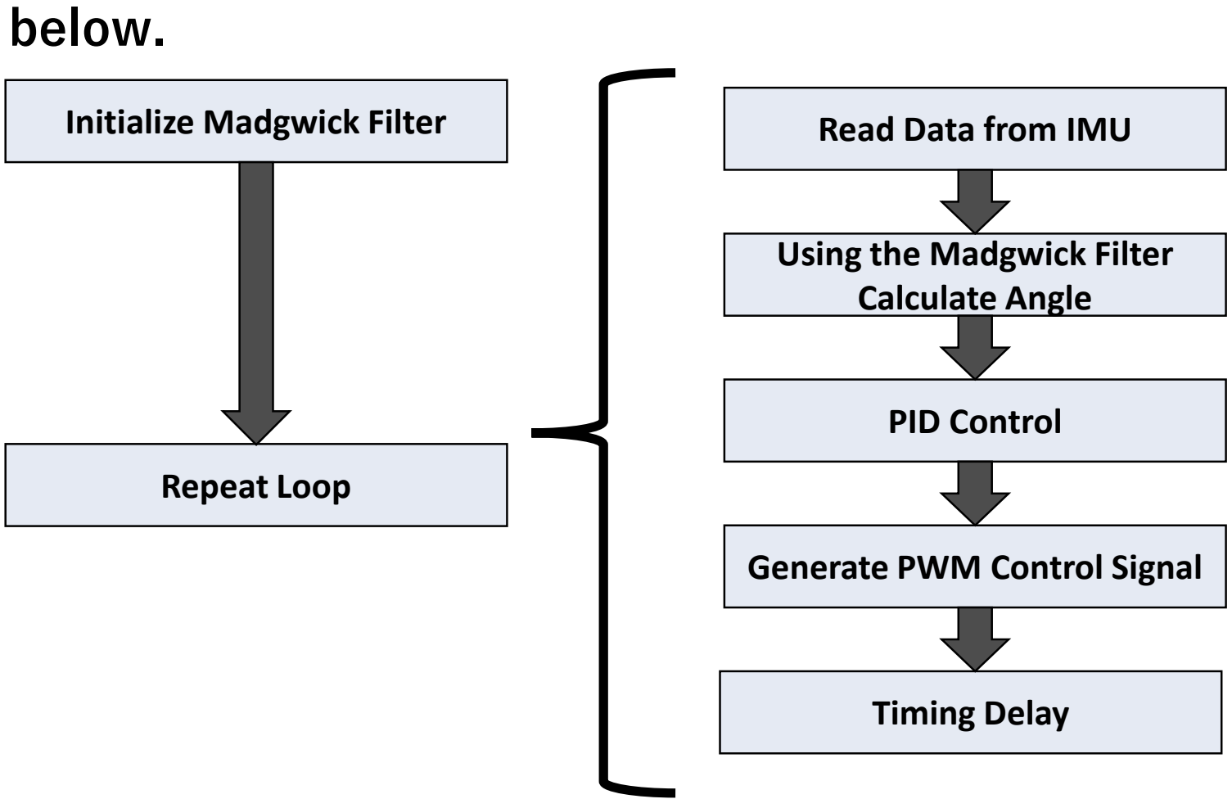
[picture p67: figure]
below.; Initialize Madgwick Filter; Read Data from IMU; Using the Madgwick Filter Calculate Angle; PID Control; Generate PWM Control Signal; Timing Delay; Repeat Loop

Robot Line

## Software: Reading Data from the IMU

◼ Read three-axis acceleration and angular velocity from the IMU. ◼ Communication with the IMU uses an existing library.

◼ The angle is calculated from three-axis acceleration and angular velocity using a Madgwick filter.
◼ (https://github.com/arduino-libraries/MadgwickAHRS) A gain- (https://github.com/arduino-libraries/MadgwickAHRS)adjustment function is added to the Madgwick- (https://github.com/arduino-libraries/MadgwickAHRS)filter library. (https://github.com/arduino-libraries/MadgwickAHRS)

5

## Software: PID Control

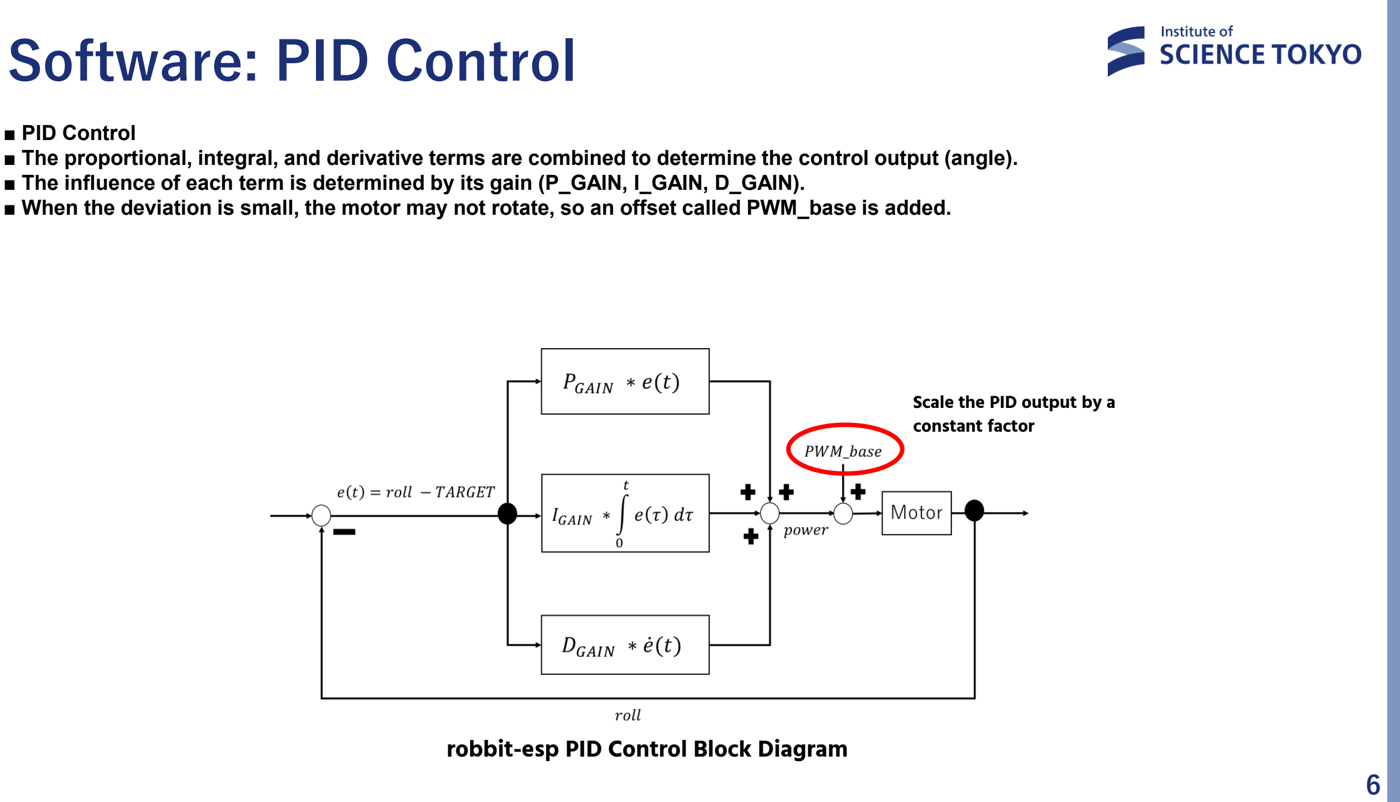
[picture p68: page 7]

6

robbit-esp PID Control Block Diagram

Scale the PID output by a
constant factor

■ PID Control
■ The proportional, integral, and derivative terms are combined to determine the control output (angle). ■ The influence of each term is determined by its gain (P_GAIN, I_GAIN, D_GAIN).
■ When the deviation is small, the motor may not rotate, so an offset called PWM_base is added.

## PID Control: Proportional Term (P)

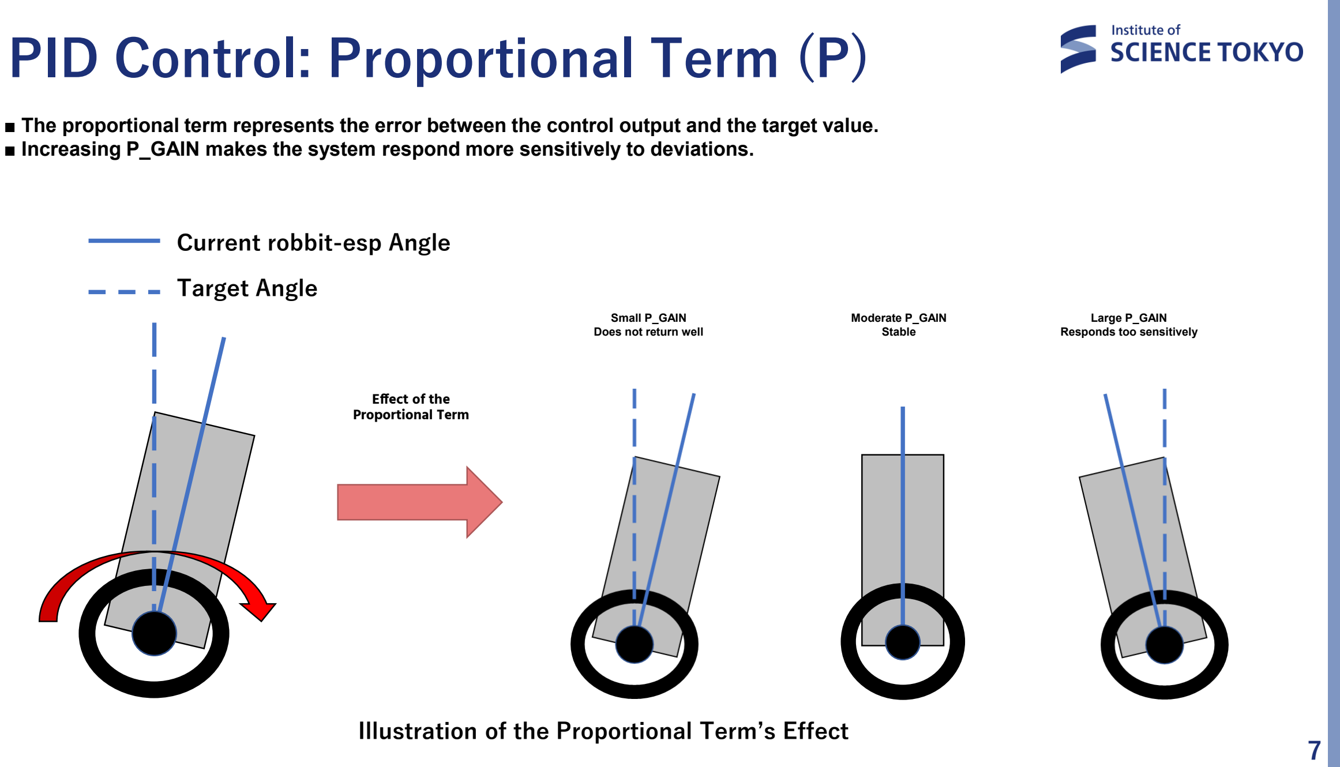
[picture p69: page 8]

7

Effect of the
Proportional Term

Current robbit-esp Angle

Target Angle

Illustration of the Proportional Term’s Effect

■ The proportional term represents the error between the control output and the target value. ■ Increasing P_GAIN makes the system respond more sensitively to deviations.

Small P_GAIN
Does not return well

Moderate P_GAIN
Stable

Large P_GAIN
Responds too sensitively

Small P_GAIN
Does not return well

Moderate P_GAIN
Stable

Large P_GAIN
Responds too sensitively

Small P_GAIN
Does not return well

Moderate P_GAIN
Stable

Large P_GAIN
Responds too sensitively

## PID Control: Integral Term (I)

8

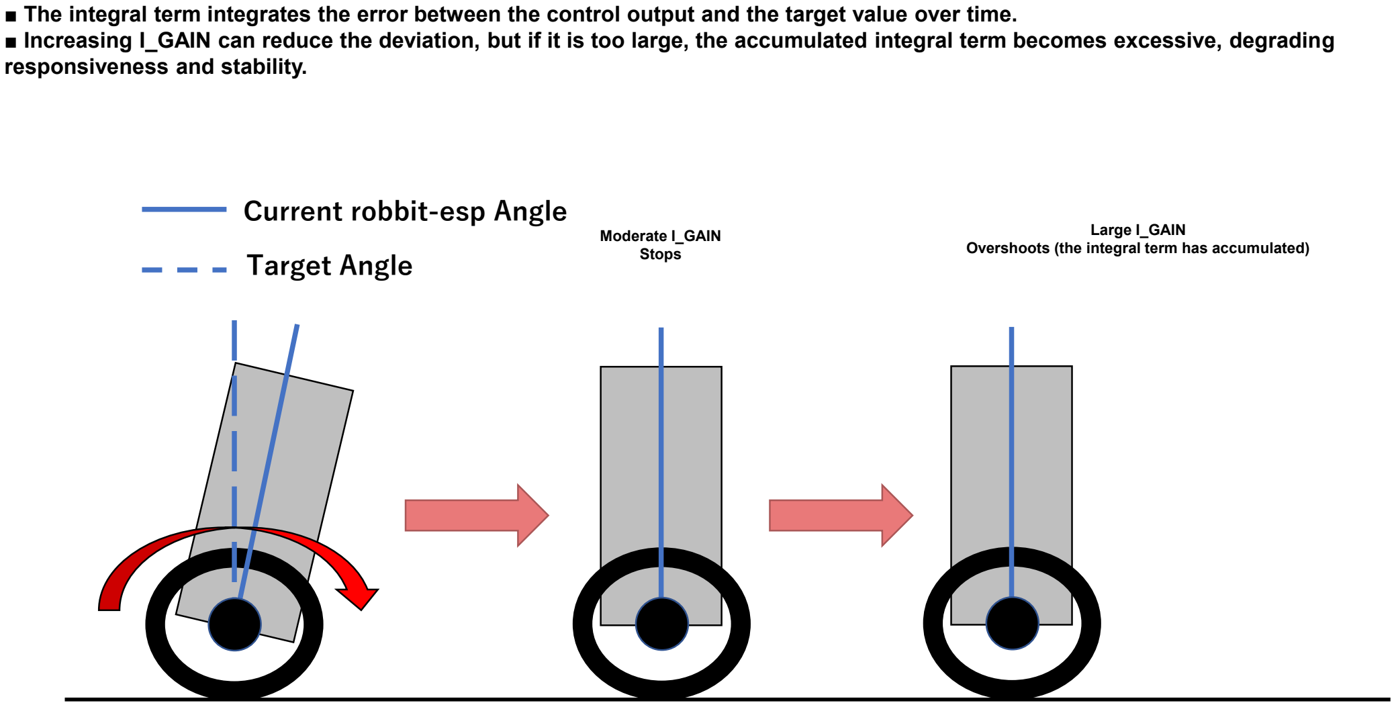
[picture p70: figure]
Target Angle; responsiveness and stability.; Moderate I_GAIN Stops; Large I_GAIN; Current robbit-esp Angle

Illustration of the Integral Term’s Effect

■ The integral term integrates the error between the control output and the target value over time.
■ Increasing I_GAIN can reduce the deviation, but if it is too large, the accumulated integral term becomes excessive, degrading

Overshoots (the integral term has accumulated)

## PID Control: Anti-Windup

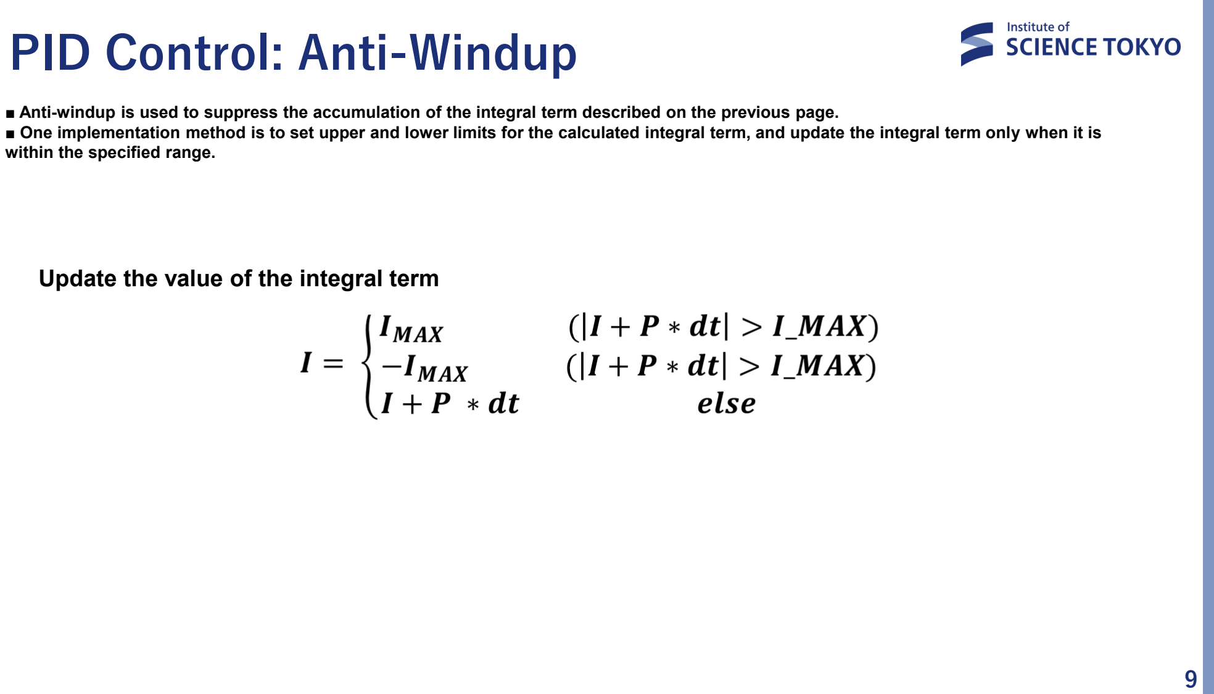
[picture p71: page 10]

9

■ Anti-windup is used to suppress the accumulation of the integral term described on the previous page.
■ One implementation method is to set upper and lower limits for the calculated integral term, and update the integral term only when it is within the specified range.

Update the value of the integral term

## PID Control: Derivative Term (D)

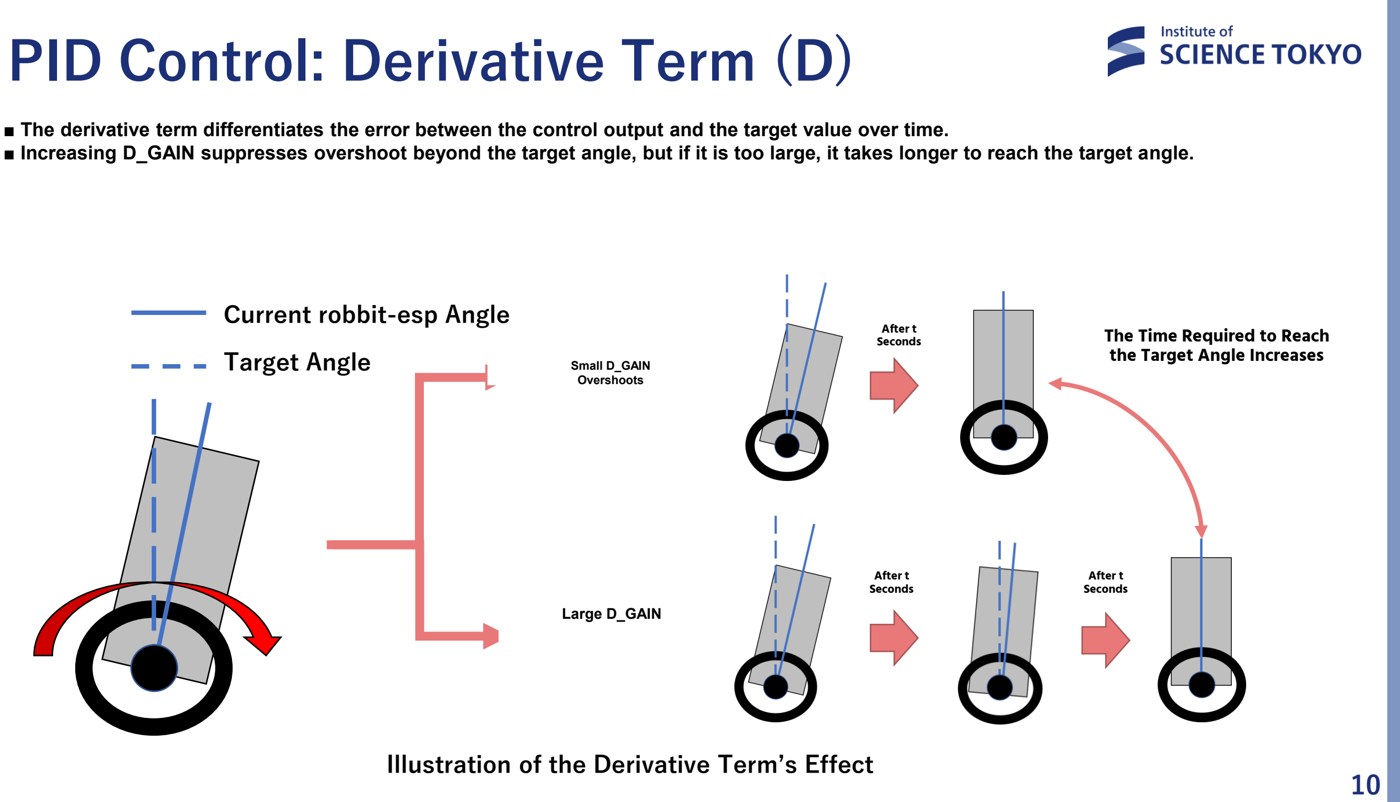
[picture p72: page 11]

10

Current robbit-esp Angle

Target Angle

Illustration of the Derivative Term’s Effect

After t
Seconds

After t
Seconds

After t
Seconds

The Time Required to Reach the Target Angle Increases

■ The derivative term differentiates the error between the control output and the target value over time.
■ Increasing D_GAIN suppresses overshoot beyond the target angle, but if it is too large, it takes longer to reach the target angle.

Small D_GAIN

Large D_GAIN

Overshoots

Small D_GAIN
Overshoots

## Software: PID Control

The PID controller is implemented as follows.

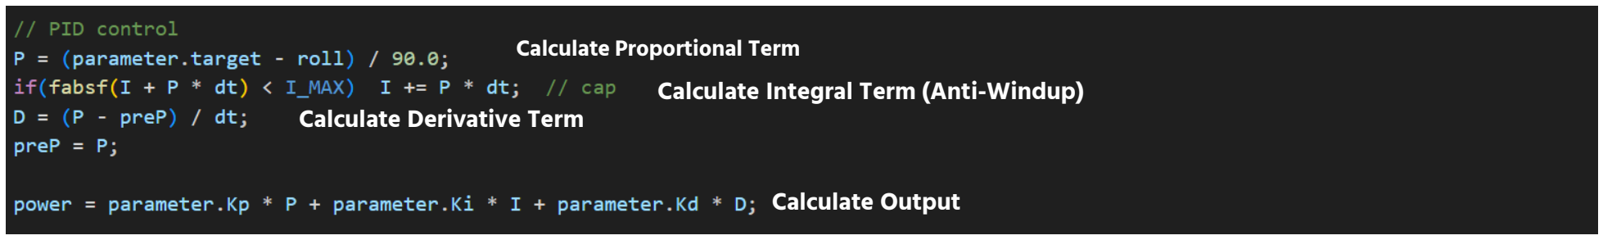
[picture p73: figure]
Calculate Proportional Term Calculate Integral Term (Anti-Windup); Calculate Derivative Term; Calculate Output

◼ P is the error between the target angle (TARGET) and current angle (roll). ◼ I integrates the proportional error using a rectangular approximation.
The `if (fabsf(I + P * dt))` expression implements the anti-windup condition. ◼ D is calculated using the finite-difference derivative formula.
◼ Finally, the terms are combined in power to calculate the output.

11

## Software: Determining the PWM Signal

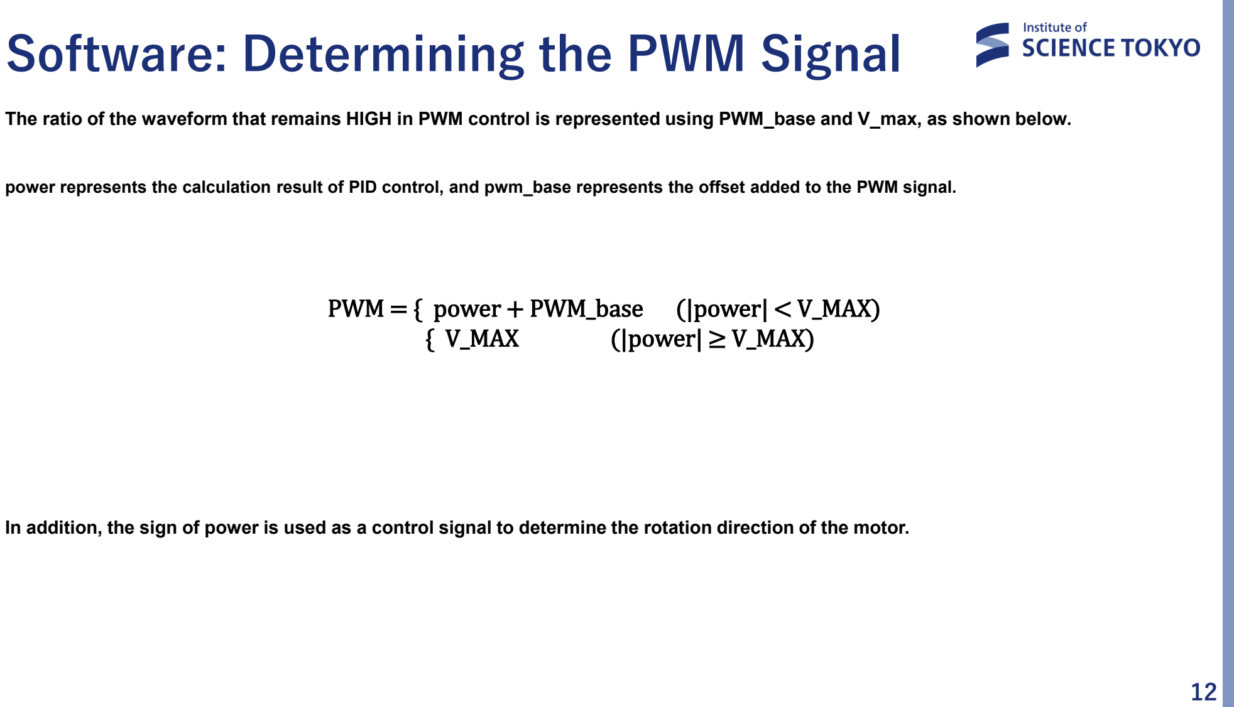
[picture p74: page 13]

12

The ratio of the waveform that remains HIGH in PWM control is represented using PWM_base and V_max, as shown below.

power represents the calculation result of PID control, and pwm_base represents the offset added to the PWM signal.

PWM = { power + PWM_base | (|power| < V_MAX)
{ V_MAX | (|power| ≥ V_MAX)

In addition, the sign of power is used as a control signal to determine the rotation direction of the motor.

## Software: BLE Communication

◼ An existing library provides the BLE connection between the PC and robbit-esp.
◼ Callback functions asynchronously send and receive data when the PC issues read or write requests.


### 13 Callback Functions

- onWrite: Handles write requests from the PC
- onRead: Handles read requests from the PC In this program, the loop function sets the value sent to the PC, so onRead performs no additional processing.
