archlab-sciencetokyo/robbit_project/robbit/setting/manual/robbit_system_manual.pdf

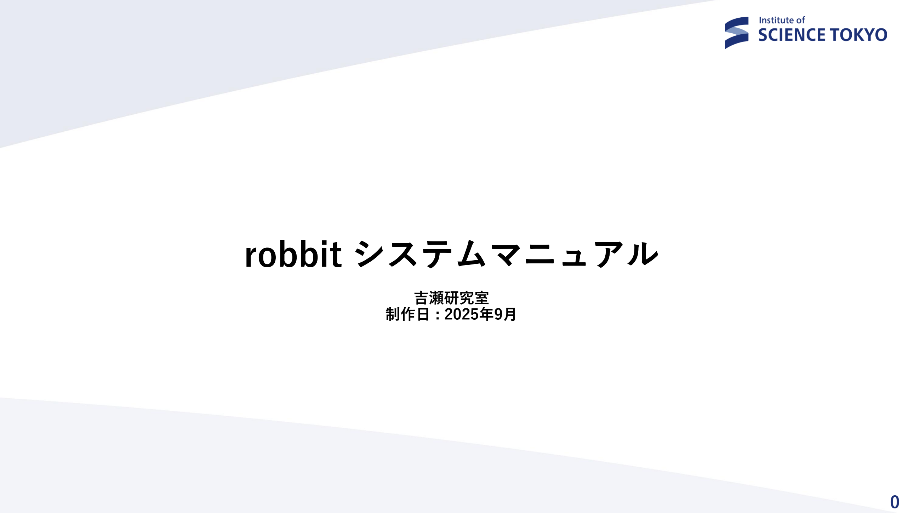
[picture p115: page 1]

## robbit システムマニュアル

0

吉瀬研究室
制作日 : 2025年9月

概要

◼ このプログラムはrobbitのハードウェア，ソフトウェア，ゲートウェアの内容を 説明している（ただし，ゲートウェアとはFPGA内に実装する回路を指す）

◼ この資料を参考にすることで，robbitのシステムを理解することができ，ソフト ウェアやゲートウェアの改善を行いやすくなる

1

## robbit : ハードウェア

2

◼ FPGA ボード: Cmod A7-35T
- サイズ: 69.9mm × 18.8mm
- 重量: 10.7g
◼ センサ: MPU-6050(IMU)
- 加速度，角速度(ジャイロ)センサ

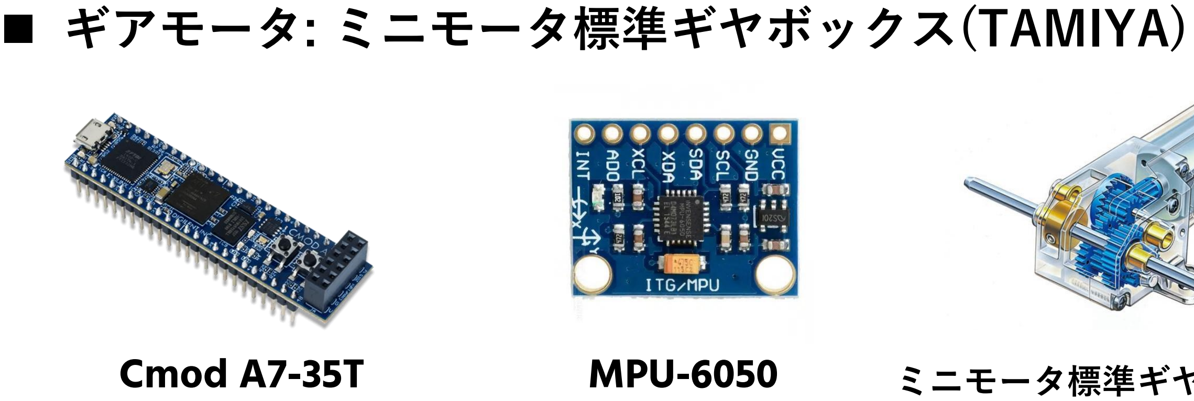
[picture p116: figure]
◼ ギアモータ: ミニモータ標準ギヤボックス(TAMIYA)
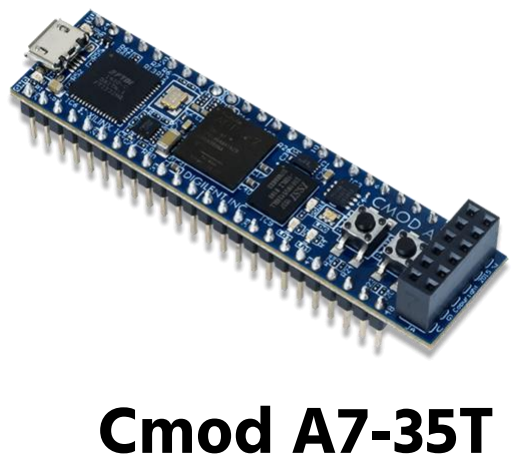
[picture p117: figure]

Cmod A7-35T | MPU-6050 | ミニモータ標準ギヤボックス(TAMIYA)

## robbit : ハードウェア

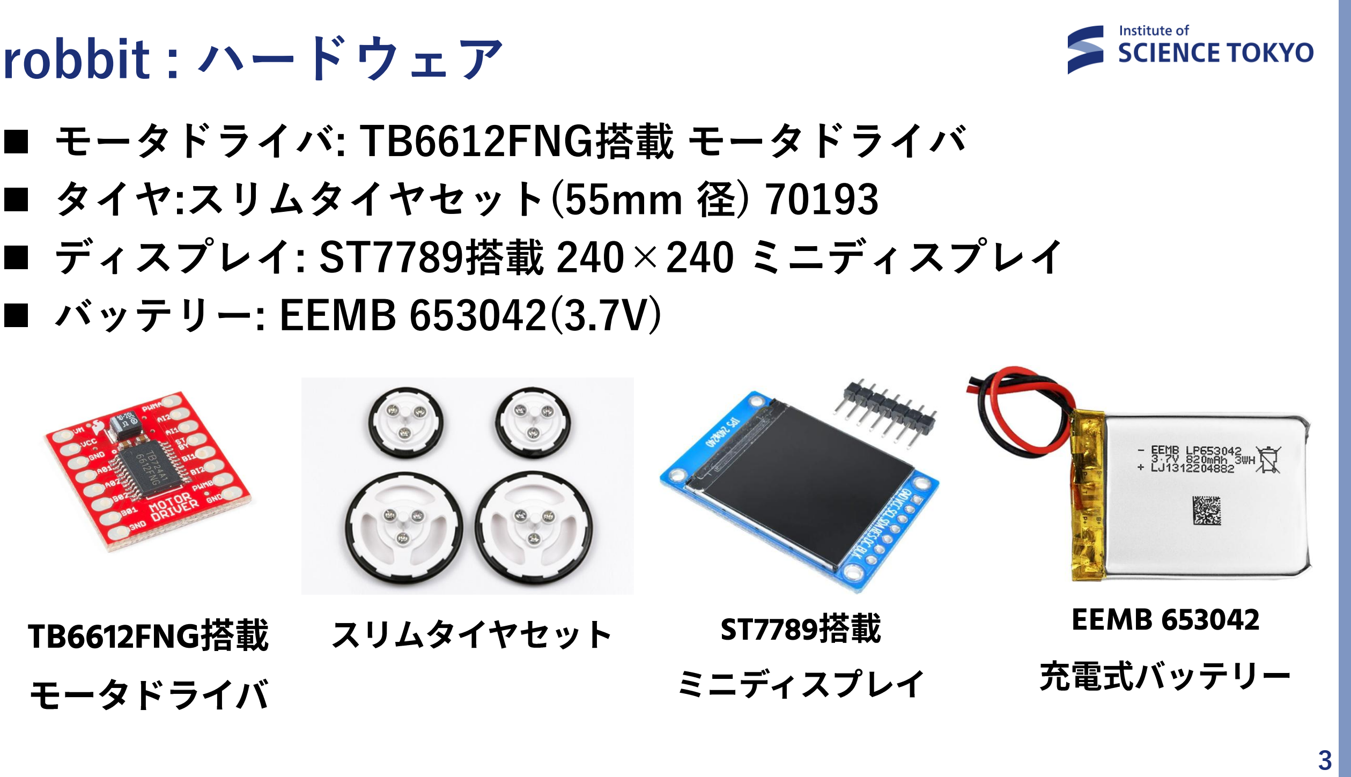
[picture p118: page 4]

3

◼ モータドライバ: TB6612FNG搭載 モータドライバ
◼ タイヤ:スリムタイヤセット(55mm 径) 70193
◼ ディスプレイ: ST7789搭載 240×240 ミニディスプレイ ◼ バッテリー: EEMB 653042(3.7V)

## TB6612FNG搭載

モータドライバ

スリムタイヤセット | ST7789搭載
| ミニディスプレイ

## EEMB 653042

充電式バッテリー

## robbit : ハードウェア

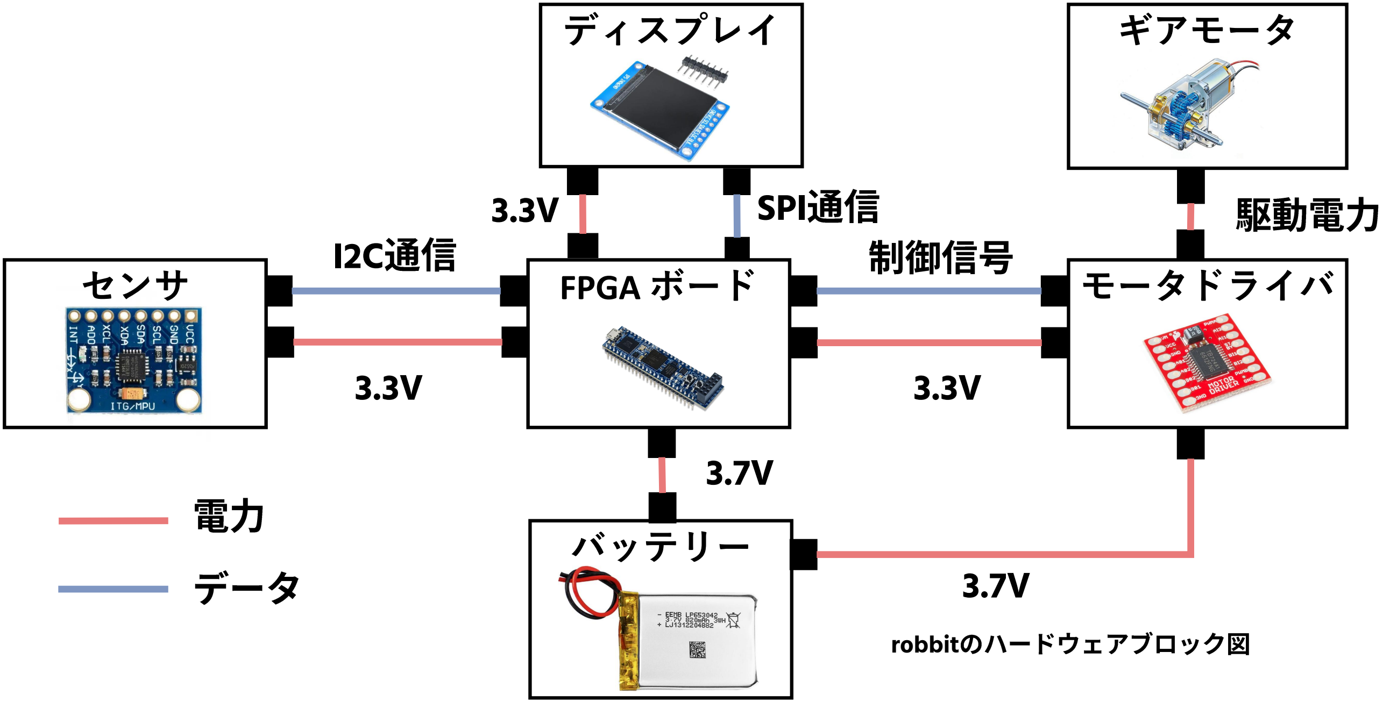
[picture p119: figure]
FPGA ボード; モータドライバ; ディスプレイ; センサ; バッテリー; ギアモータ; SPI通信; I2C通信; 制御信号; データ; robbitのハードウェアブロック図; 駆動電力

4

## ゲートウェア: 概要

5

◼ (https://github.com/archlab-sciencetokyo/CFU-Proving-Ground) CFU- (https://github.com/archlab-sciencetokyo/CFU-Proving-Ground)Proving- (https://github.com/archlab-sciencetokyo/CFU-Proving-Ground)Groundを使用する (https://github.com/archlab-sciencetokyo/CFU-Proving-Ground)
- 175MHzまでの高速制御をサポート
- ミニディスプレイをサポート済み
- Meomory-Mapped I/O(MMIO)を柔軟 に設計可能

CFU-Proving-Groundにモータドライバ モジュール, IMUモジュールを追加

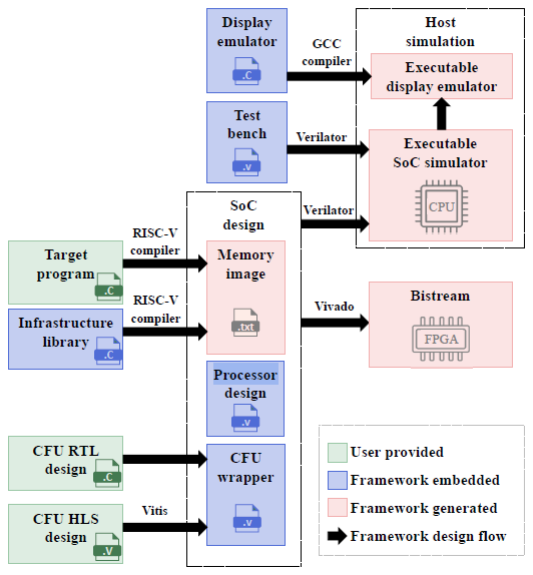
[picture p120: figure]

[1] Aoba Fuzino, Kenji Kise. “CFU Proving Ground,” https://github.com/archlab-sciencetokyo/CFU-Proving-Ground. Accessed: 2025-09-15.

## ゲートウェア: 概要

各Verilogファイルで行われている処理内容は以下の通り
- main.v
ディスプレイとのSPI通信，
- mpu.v
IMUとのI2C通信によるデータの送受信
- proc.v
32bitのRISC-Vプロセッサを実装
- robbit.v
モータドライバ制御モジュール(tb6612fng) : PWM制御を担当 MMIOモジュール : robbitで新たに使用するメモリ領域にデータを書き込む

mpu.vとrobbit.vはCFU Proving Groundから新たに追加したプログラムである

6

## ゲートウェア : I2C通信モジュール

◼ MPU-6050との通信はI2C通信で行う
◼ mpu.vにあるmpu6050モジュールとi2c_masterモジュールが担当している mpu6050モジュール: I2C通信でのデータやり取りのタイミング制御 i2c_masterモジュール: IMUとFPGAのデータのやり取りを担う

◼ I2C通信はsclとsdaという2本の通信線でデータのやり取りを行う sclがクロックの役割を果たし，sdaがデータバスの役割を果たす ◼ sclに合わせてsdaにデータを1bitずつ送受信する

7

Master
(PC)

Slave
(IMU)

scl

sda

## ゲートウェア : tb6612fngモジュール

◼ robbit.v内に，モータドライバを制御するtb6612fngモジュールが存在する ◼ モータドライバにPWM制御の制御信号を送る
◼ PWM制御
- 電気信号のON/OFF(デューティー比)の割合でモータの強さを制御する ONの割合が大きい = モータの回転速度が速い
ONの割合が小さい = モータの回転速度が遅い

8

モータの回転速度が速い場合

## 0 2047 cycle

## ON(HIGH) OFF(LOW)

## 0 2047 cycle

ON(HIGH) | OFF(LOW)

モータの回転速度が遅い場合

## robbit : ソフトウェア

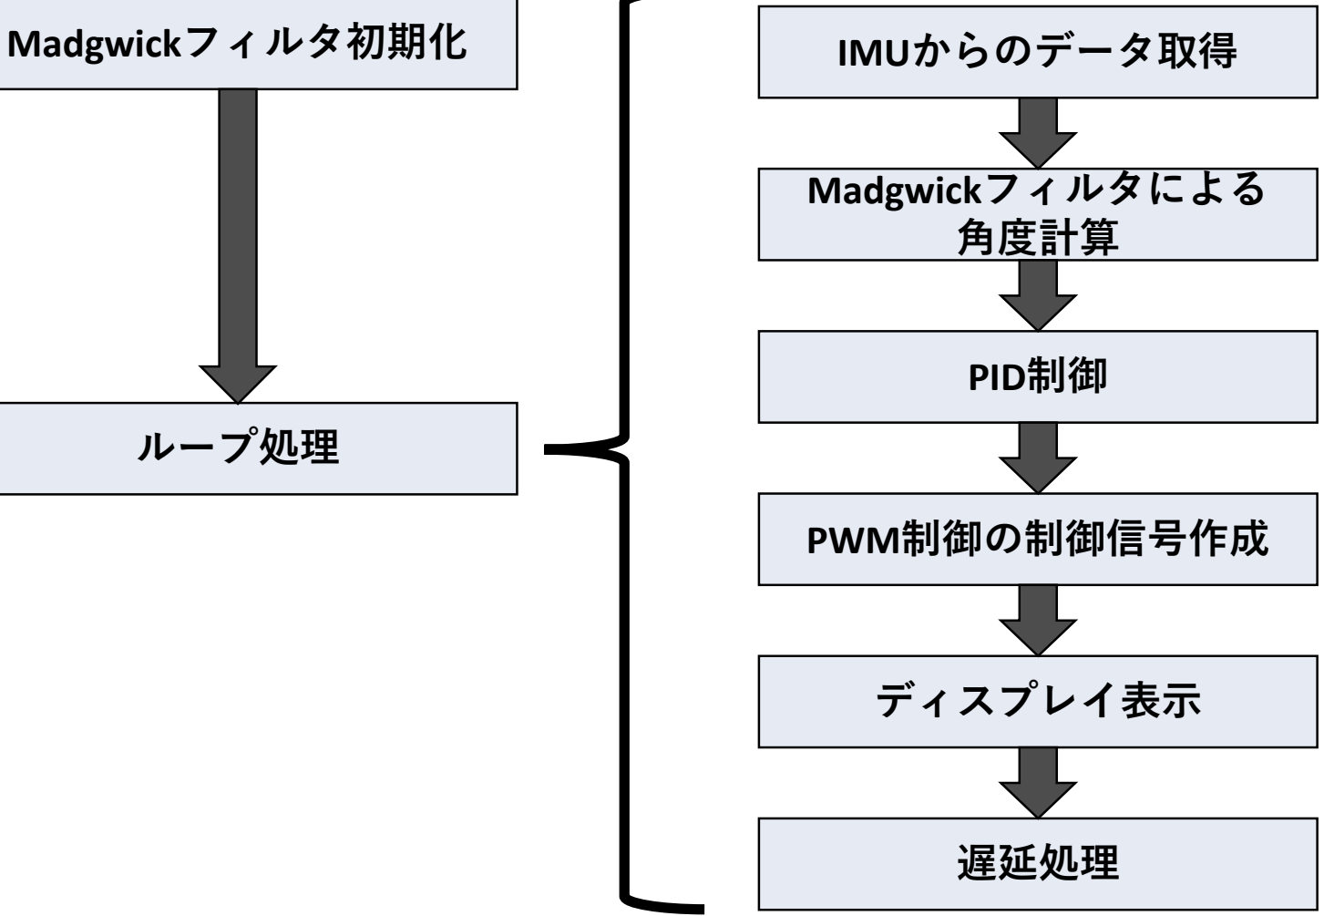
[picture p121: figure]
Madgwickフィルタ初期化; IMUからのデータ取得; Madgwickフィルタによる 角度計算; PID制御; PWM制御の制御信号作成; ディスプレイ表示; 遅延処理; ループ処理
垂直線; 求める角度

9

robbitの傾き

## ソフトウェア: IMUからのデータ取得

◼ IMUから3軸の加速度と角速度を取得する
◼ 実際にはゲートウェア上でMemory-Mapped IO(MMIO)によって加速度と角 速度が書き込まれた後に，ソフトウェアで該当するアドレスにアクセスして データを読み込んでいる

10

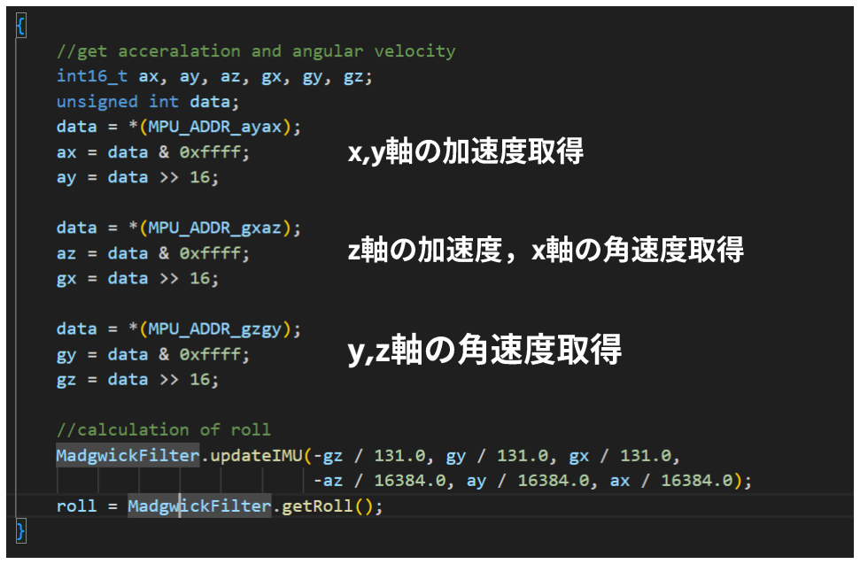
[picture p122: figure]
x,y軸の加速度取得; z軸の加速度， x軸の角速度取得; y,z軸の角速度取得

## ソフトウェア: Madgwickフィルタ

◼ 3軸の加速度と角速度とMadgwickフィルタを利用することで角度を算出する

◼ Madgwickフィルタの処理は，Madgwickフォルダにライブラリとして保存してい る

11

## ソフトウェア: PID制御

◼ PID制御
- 比例，積分，微分要素を組み合わせて操作量(角度)を決める
- 各要素の影響度合いは，ゲインによって決定される(PGAIN, IGAIN, DGAIN)

Power = PGAIN × P + IGAIN × I + DGAIN × D

12

## PID制御: 比例要素(P成分)

◼ 比例要素は操作量と目標値の誤差で表される
◼ PGAINが大きいと，偏差に対して敏感に反応する

13

過剰に動く

比例要素の反映

PGAINが小さい

PGAINが適切

安定する

PGAINが大きい

robbitの現在角度

目標角度

戻りきらない

比例要素の影響によるrobbitの動作イメージ

## PID制御: 積分要素(I成分)

◼ 積分要素は操作量と目標値の誤差を時間積分している
◼ IGAINを大きくすると偏差を小さくできるが，大きすぎるとI成分の蓄積が大 きくなり，システムの速応性や安定性が悪くなる

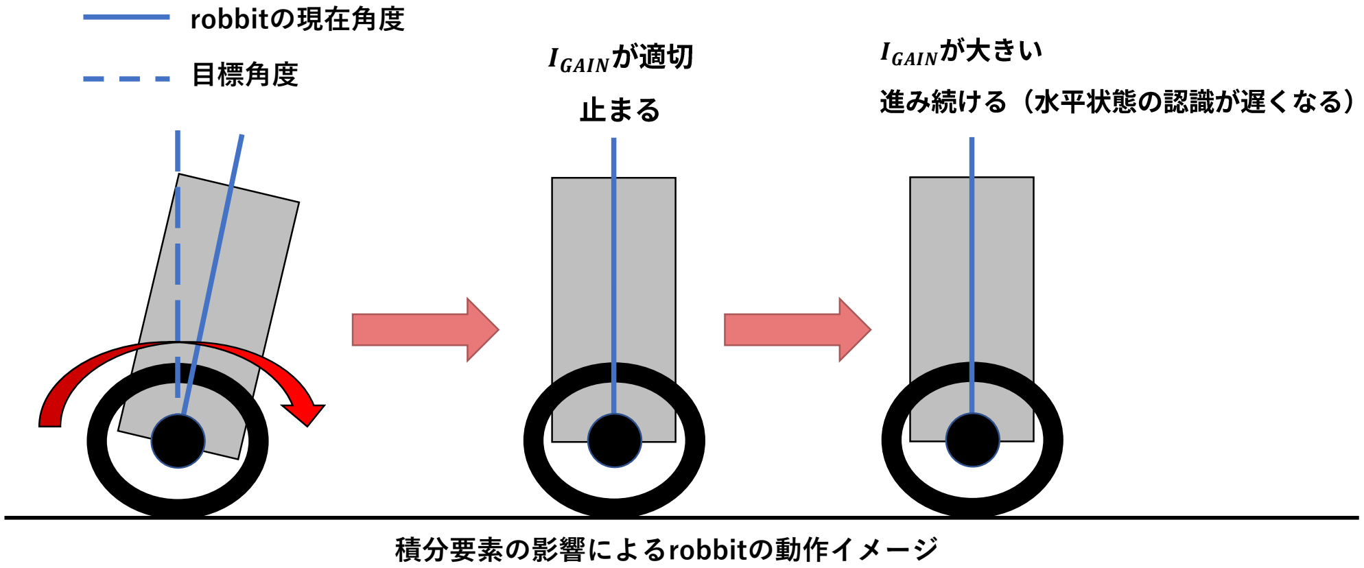
[picture p123: figure]
robbitの現在角度; 目標角度; 積分要素の影響によるrobbitの動作イメージ; IGAINが適切; 止まる; IGAINが大きい; 進み続ける（水平状態の認識が遅くなる）

14

## PID制御: アンチワインドアップ

◼ 前ページで述べた積分要素の蓄積を抑える手段としてアンチワインドアップが存 在する
◼ 実装方法は，積分要素の計算結果に対して上限と下限を設定し，範囲内だったら 積分要素の値を更新する

I = ቐ
IMAX | ( | I + P ∗ dt | > I_MAX)
−IMAX | ( | I + P ∗ dt | > I_MAX)
I + P ∗ dt | else

15

## PID制御: 微分要素(D成分)

◼ 微分要素は操作量と目標値の誤差を時間微分している
◼ DGAINを大きくすると，目標角度を行き過ぎるオーバーシュートが抑制され る。大きすぎると目標角度に到達する時間が長くなる。

16

robbitの現在角度

目標角度


微分要素の影響によるrobbitの動作イメージ


DGAINが適切

DGAINが大きい

t秒後


t秒後 | t秒後

目標角度に達するまで
の時間差が生まれる

## ソフトウェア: PID制御

PID制御の実装は以下の通り

比例要素の計算; 積分要素の計算（アンチワインドアップ）; 微分要素の計算; 出力の計算

◼ 変数Pでは比例要素を計算するため，目標角度(TARGET)と現在角度(roll)の偏差 を導出する
◼ 変数Iでは積分要素を求めるため，比例要素を長方形近似で積分している If(fabsf(I+P*dt))の部分がアンチワインドアップの条件式に該当する
◼ 変数Dでは微分要素を求めるため，微分の公式を用いて計算を行っている ◼ 最後にpowerにすべての要素の値を足し合わせることで出力を計算する

17

## ソフトウェア: PWM信号の決定

PWM制御の制御信号として，波形がHIGHの割合をPWMbaseからVmaxで表現する 式で表すと以下の通りである
powerはPID制御の計算結果を表し， pwmbaseはPWM信号の増加分を表す

PWM = ቊ
Power + PWMbase | power | < VMAX
VMAX | power | ≥ VMAX

また，powerの符号はモータの回転方向を決める制御信号として使われる

18
