archlab-sciencetokyo/robbit_project/robbit/setting/manual/robbit_system_manual_en.pdf

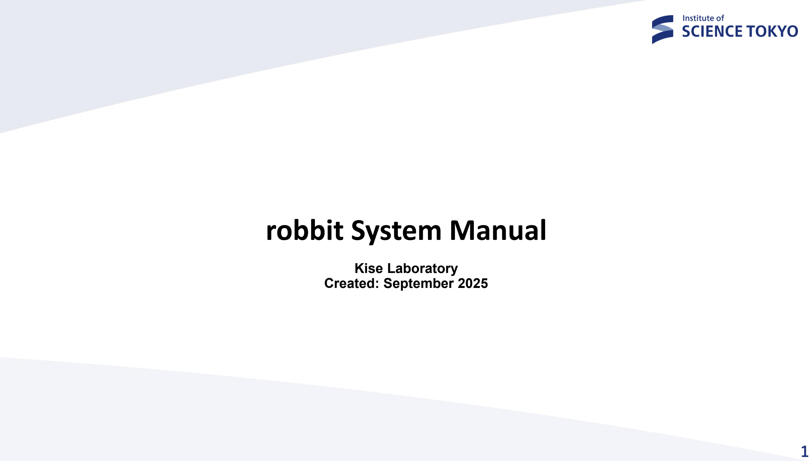
[picture p124: page 1]

## robbit System Manual

1

Kise Laboratory
Created: September 2025

## Overview

◼ This manual describes the hardware, software, and gateway of robbit. Here, “gateway” refers to the circuitry implemented in the FPGA.

◼ This manual helps readers understand the robbit system and improve its software and gateway.

2

## robbit: Hardware

3

◼ FPGA board: Cmod A7-35T
- Dimensions: 69.9 mm × 18.8 mm
- Weight: 10.7 g
◼ Sensor: MPU-6050 (IMU)
- Accelerometer and angular-velocity (gyroscope) sensor

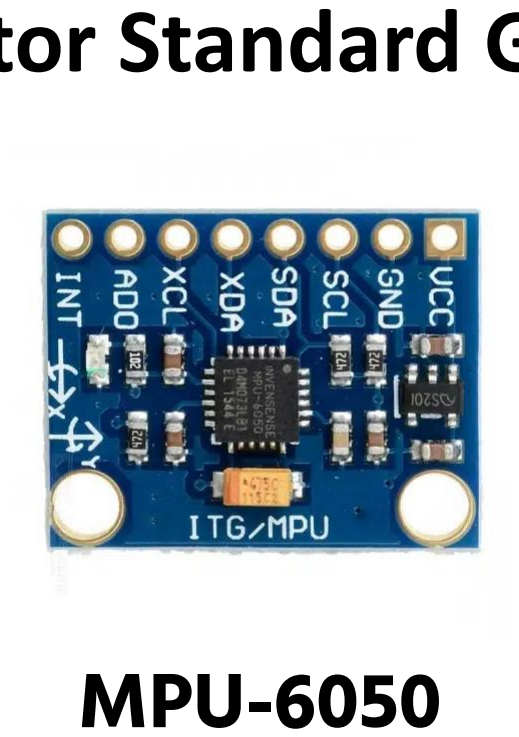
[picture p125: figure]

◼ Geared motor: Mini Motor Standard Gearbox (TAMIYA)

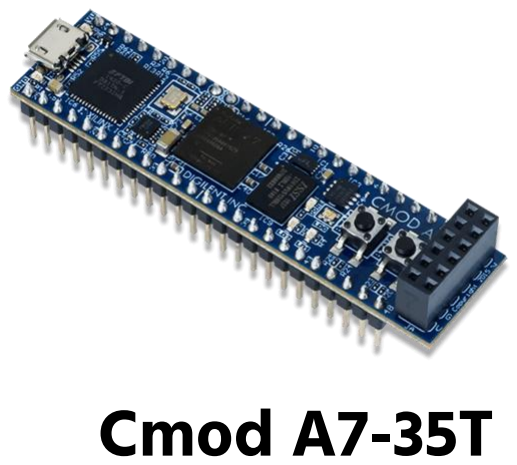
[picture p126: figure]

Cmod A7-35T | MPU-6050 | Mini Motor Standard Gearbox (TAMIYA)

## robbit: Hardware

4

◼ Motor driver: TB6612FNG motor-driver module ◼ Tires: Slim Tire Set (55 mm diameter), 70193
◼ Display: 240 × 240 mini display with ST7789
◼ Battery: EEMB 653042 (3.7 V)

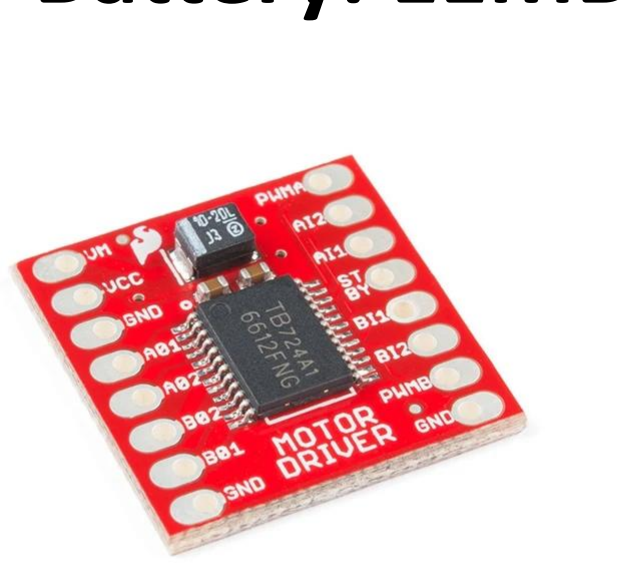
[picture p127: figure]

## TB6612FNG Motor Driver

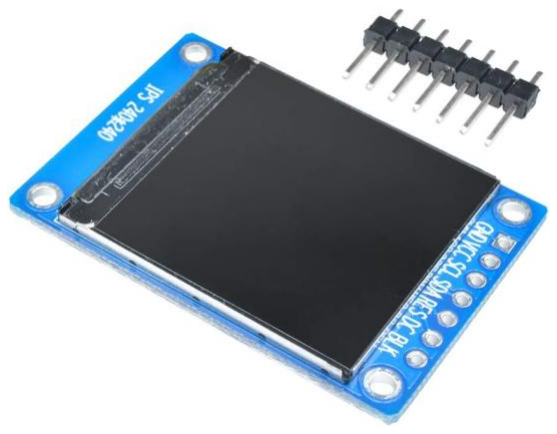
[picture p128: figure]

Slim Tire Set | ST7789 Mini Display

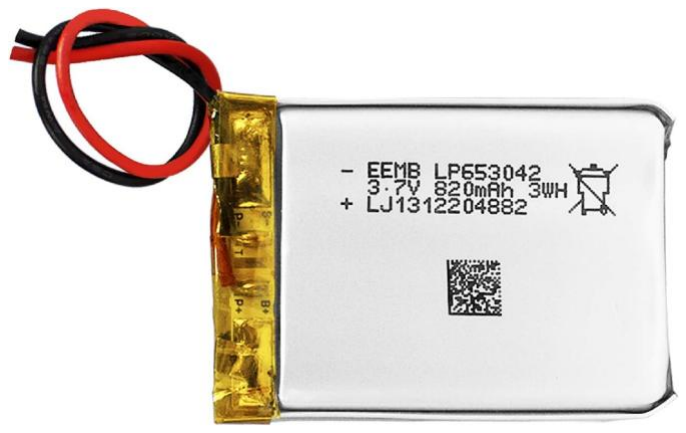
[picture p129: figure]

## EEMB 653042 Rechargeable Battery

## robbit: Hardware

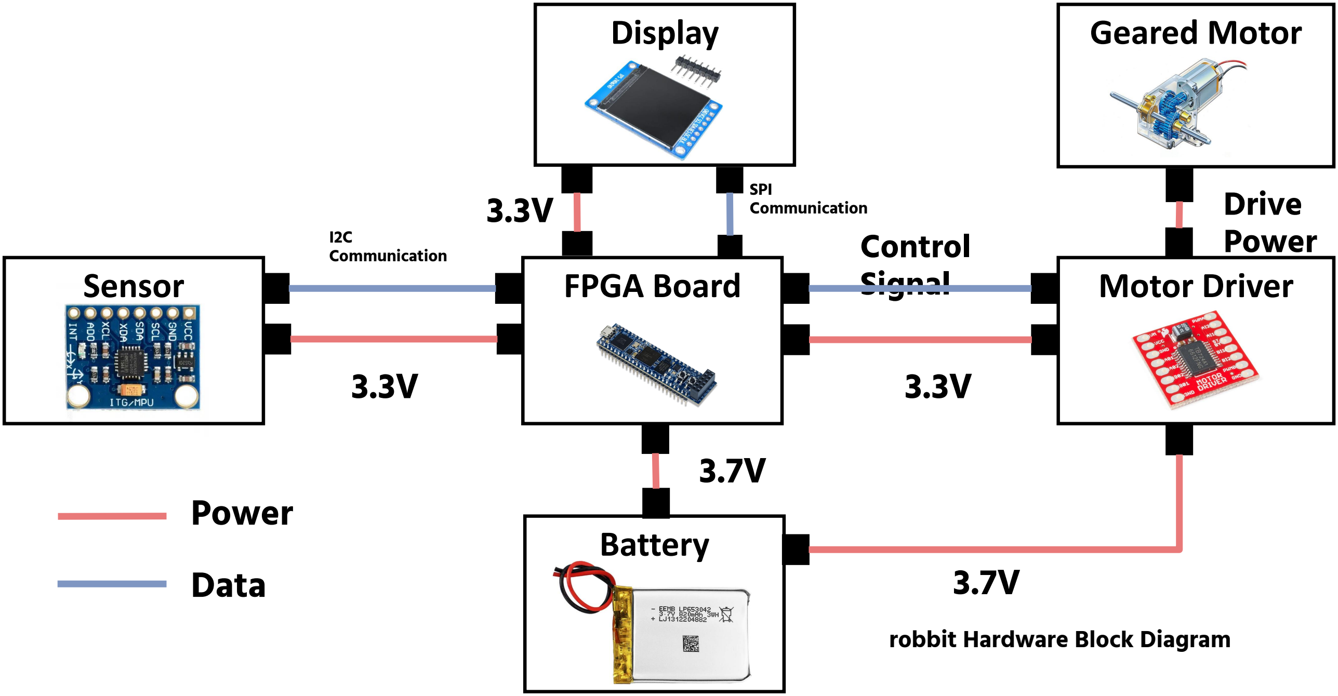
[picture p130: figure]
FPGA Board; Motor Driver; Display; Sensor; Battery; Geared Motor; SPI Communication; I2C Communication; Control Signal; Power Data; robbit Hardware Block Diagram; Drive; Power

5

## Gateway: Overview

6

◼ (https://github.com/archlab-sciencetokyo/CFU-Proving-Ground) Uses CFU (https://github.com/archlab-sciencetokyo/CFU-Proving-Ground)- (https://github.com/archlab-sciencetokyo/CFU-Proving-Ground)Proving (https://github.com/archlab-sciencetokyo/CFU-Proving-Ground)- (https://github.com/archlab-sciencetokyo/CFU-Proving-Ground)Ground (https://github.com/archlab-sciencetokyo/CFU-Proving-Ground)
- Supports high-speed control up to 175 MHz
- Supports a mini display
- Enables flexible Memory-Mapped I/O (MMIO) design

Adds motor-driver and IMU modules to CFU-Proving-Ground


[1] Aoba Fuzino, Kenji Kise. “CFU Proving Ground,” https://github.com/archlab-sciencetokyo/CFU-Proving-Ground. Accessed: 2025-09-15.

## Gateway: Overview

The Verilog files perform the following functions:
- main.v
SPI communication with the display
- mpu.v
I2C data transfer with the IMU
- proc.v
Implements a 32-bit RISC-V processor
- robbit.v
Motor-driver control module (tb6612fng) for PWM control
MMIO module: Reads and writes the memory region added for robbit

mpu.v and robbit.v are modules added to CFU Proving Ground.

7

## Gateway: I2C Communication Module

◼ The FPGA communicates with the MPU-6050 over I2C.
◼ The mpu6050 and i2c_master modules in mpu.v handle this communication. mpu6050 module: Controls the timing of I2C data transfers
i2c_master module: Transfers data between the IMU and FPGA

◼ I2C uses two signal lines, SCL and SDA.
SCL carries the clock, while SDA carries data.
◼ Data is transferred one bit at a time on SDA in synchronization with SCL.

8

Master
(PC)

Slave
(IMU)

scl

sda

## Gateway: tb6612fng Module

◼ robbit.v contains the tb6612fng module that controls the motor driver. ◼ It sends PWM control signals to the motor driver.
◼ PWM Control
- Motor output is controlled by the signal’s ON/OFF ratio (duty cycle). Higher ON ratio = faster motor rotation
Lower ON ratio = slower motor rotation

9

### Faster Motor Rotation

## 0 2047 cycle

ON(HIGH) OFF(LOW)

## 0 2047 cycle

ON(HIGH) | OFF(LOW)

### Slower Motor Rotation

## robbit: Software

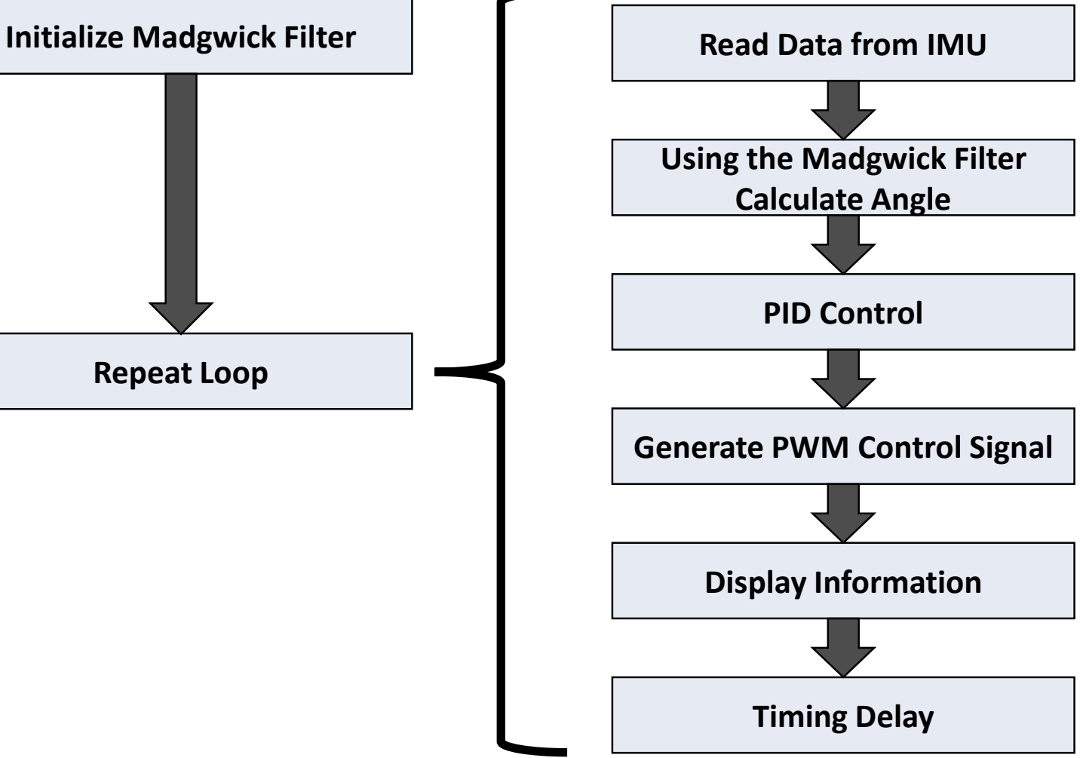
[picture p131: figure]
Initialize Madgwick Filter; Read Data from IMU; Using the Madgwick Filter Calculate Angle; PID Control; Generate PWM Control Signal; Display Information; Timing Delay; Repeat Loop

robbit Tilt

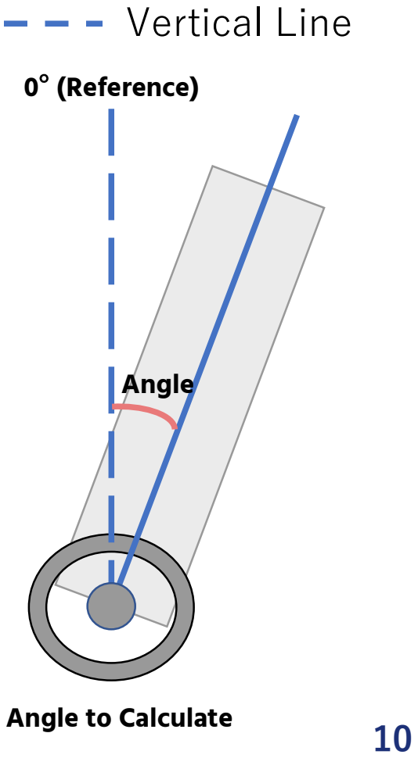
[picture p132: figure]
Vertical Line; Angle to Calculate; Angle; 0°(Reference)

## Software: Reading Data from the IMU

◼ Read three-axis acceleration and angular velocity from the IMU.
◼ The gateway writes acceleration and angular-velocity data through Memory-Mapped I/O (MMIO), and the software reads the corresponding addresses.

11

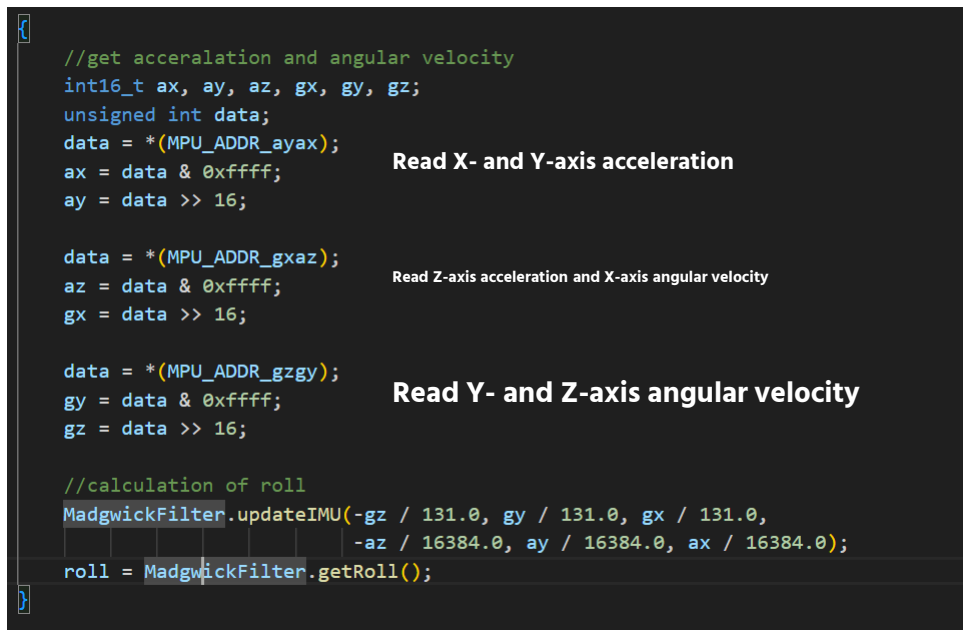
[picture p133: figure]
Read X- and Y-axis acceleration; Read Y- and Z-axis angular velocity

Read Z-axis acceleration and X-axis angular velocity

## Software: Madgwick Filter

◼ The angle is calculated from three-axis acceleration and angular velocity using a Madgwick filter.

◼ The Madgwick-filter implementation is stored as a library in the Madgwick directory.

12

## Software: PID Control

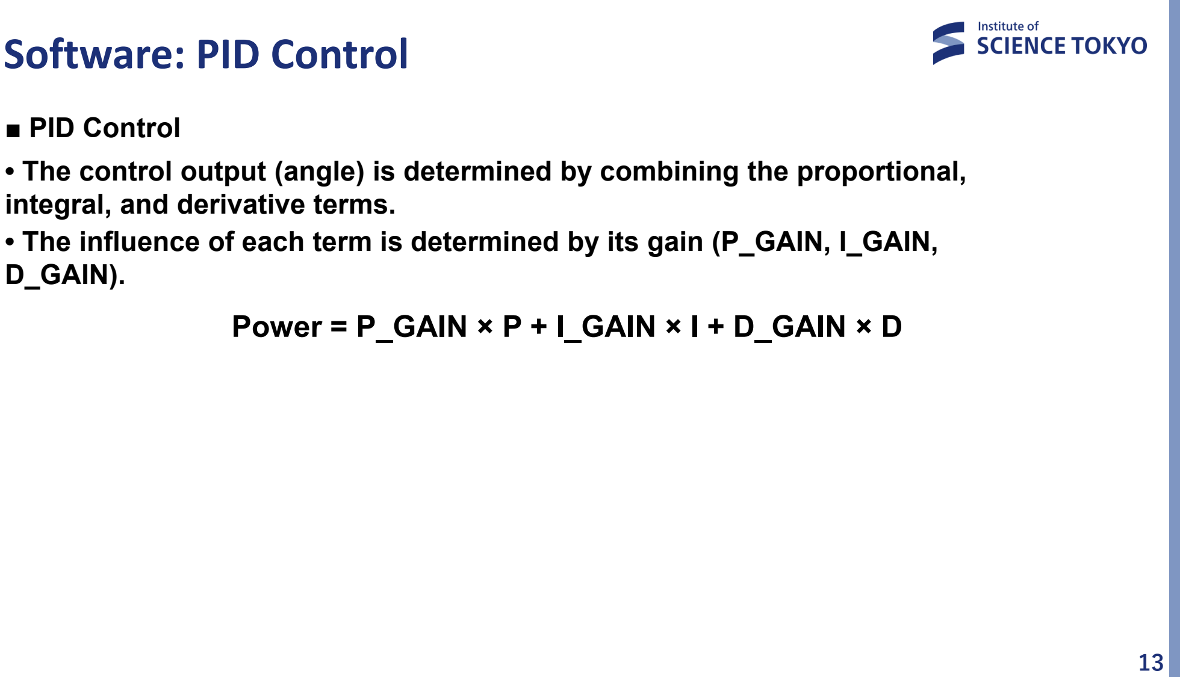
[picture p134: page 13]

13

■ PID Control
- The control output (angle) is determined by combining the proportional, integral, and derivative terms.
- The influence of each term is determined by its gain (P_GAIN, I_GAIN, D_GAIN).

Power = P_GAIN × P + I_GAIN × I + D_GAIN × D

## PID Control: Proportional Term (P)

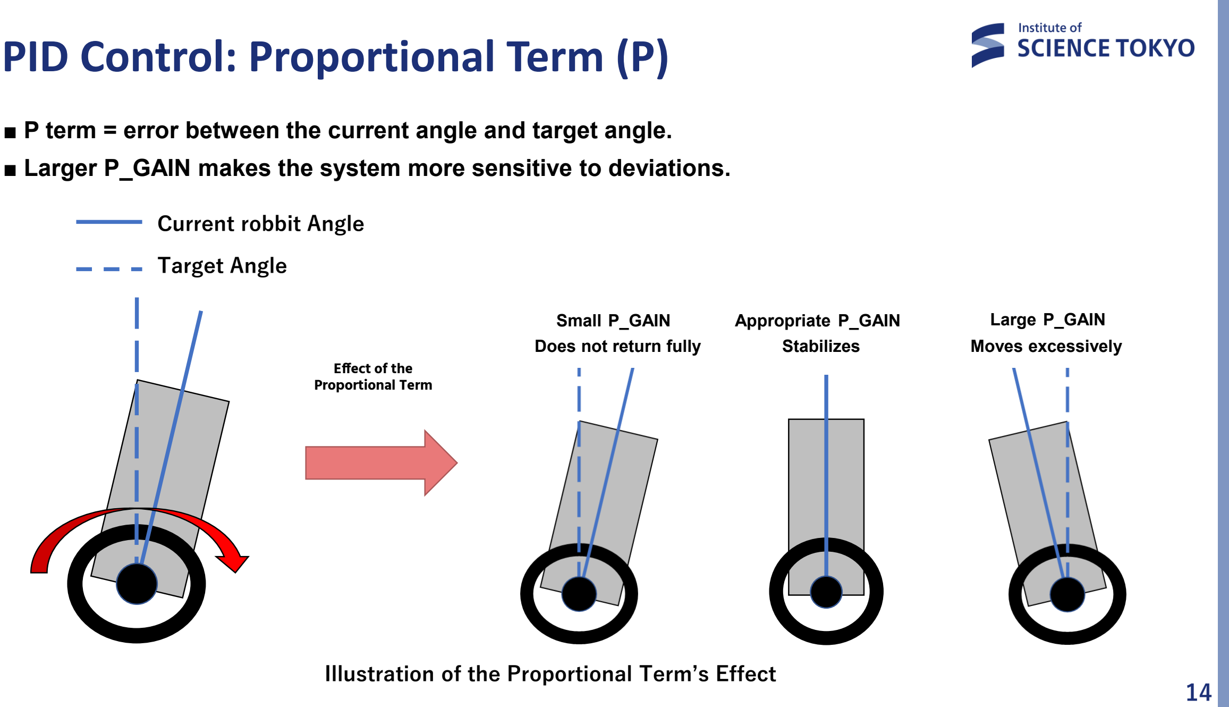
[picture p135: page 14]

14

Effect of the
Proportional Term

Current robbit Angle

Target Angle

Illustration of the Proportional Term’s Effect

■ P term = error between the current angle and target angle.
■ Larger P_GAIN makes the system more sensitive to deviations.

Small P_GAIN
Does not return fully

Appropriate P_GAIN
Stabilizes

Large P_GAIN
Moves excessively

## PID Control: Integral Term (I)

15

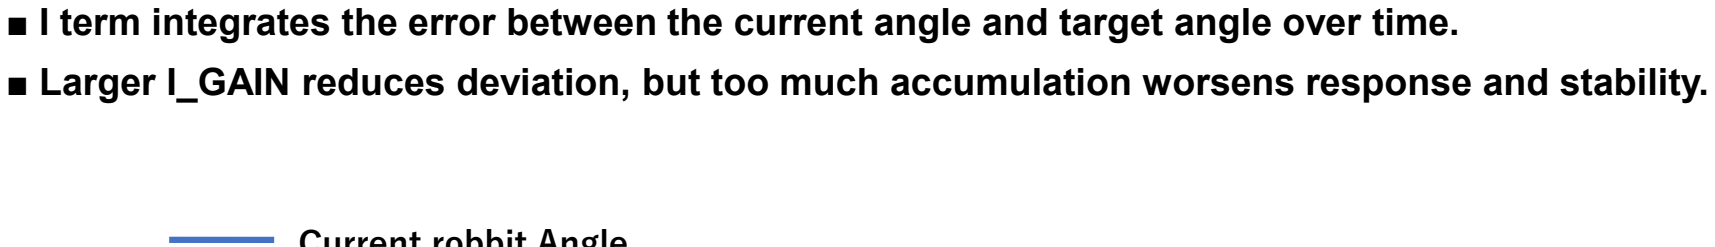
[picture p136: figure]
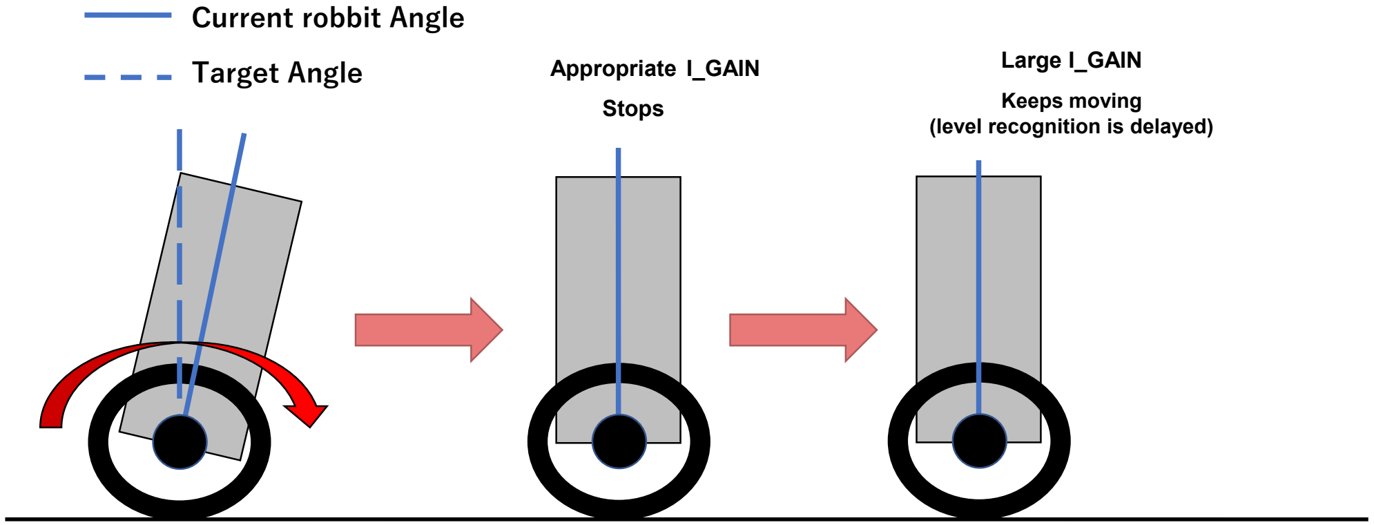
[picture p137: figure]
Current robbit Angle; Target Angle; Appropriate I_GAIN; Stops; Large I_GAIN; Keeps moving (level recognition is delayed)

Illustration of the Integral Term’s Effect

■ I term integrates the error between the current angle and target angle over time.
■ Larger I_GAIN reduces deviation, but too much accumulation worsens response and stability.

## PID Control: Anti-Windup

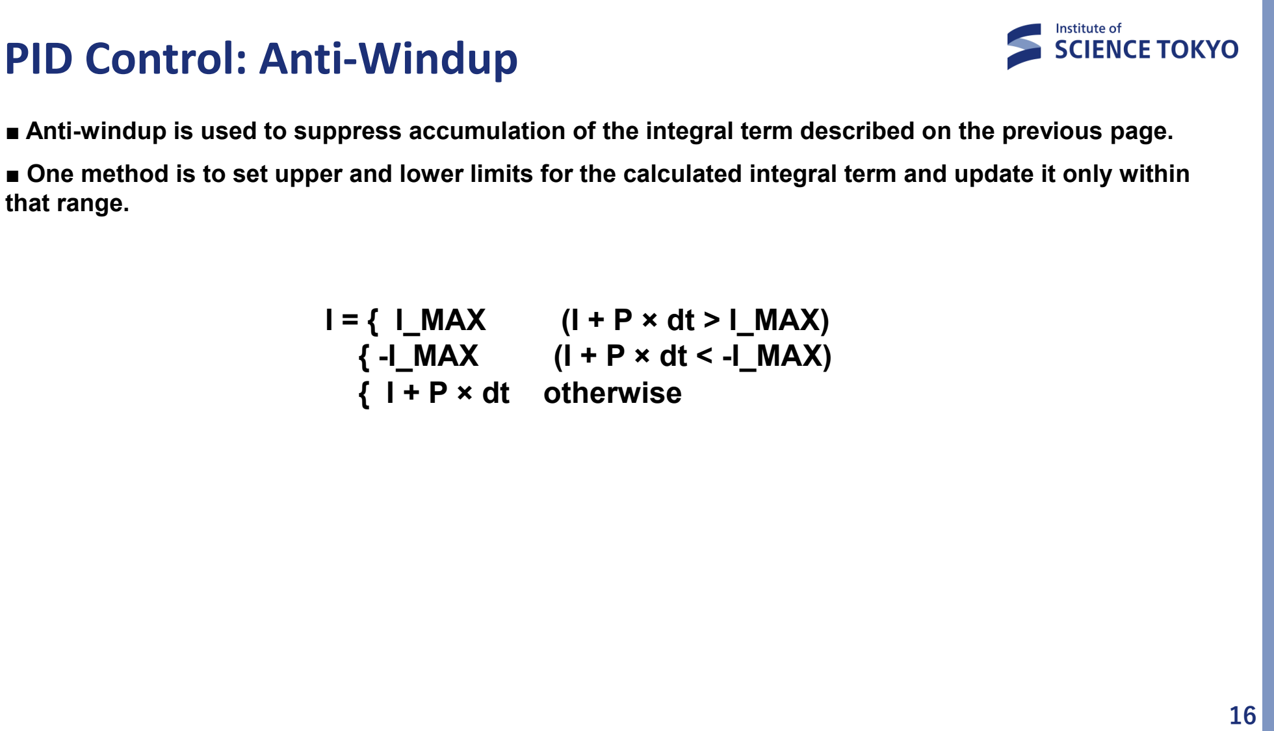
[picture p138: page 16]

16

■ Anti-windup is used to suppress accumulation of the integral term described on the previous page.

■ One method is to set upper and lower limits for the calculated integral term and update it only within that range.

I = { I_MAX | (I + P × dt > I_MAX)
{ -I_MAX | (I + P × dt < -I_MAX)
{ I + P × dt otherwise

## PID Control: Derivative Term (D)

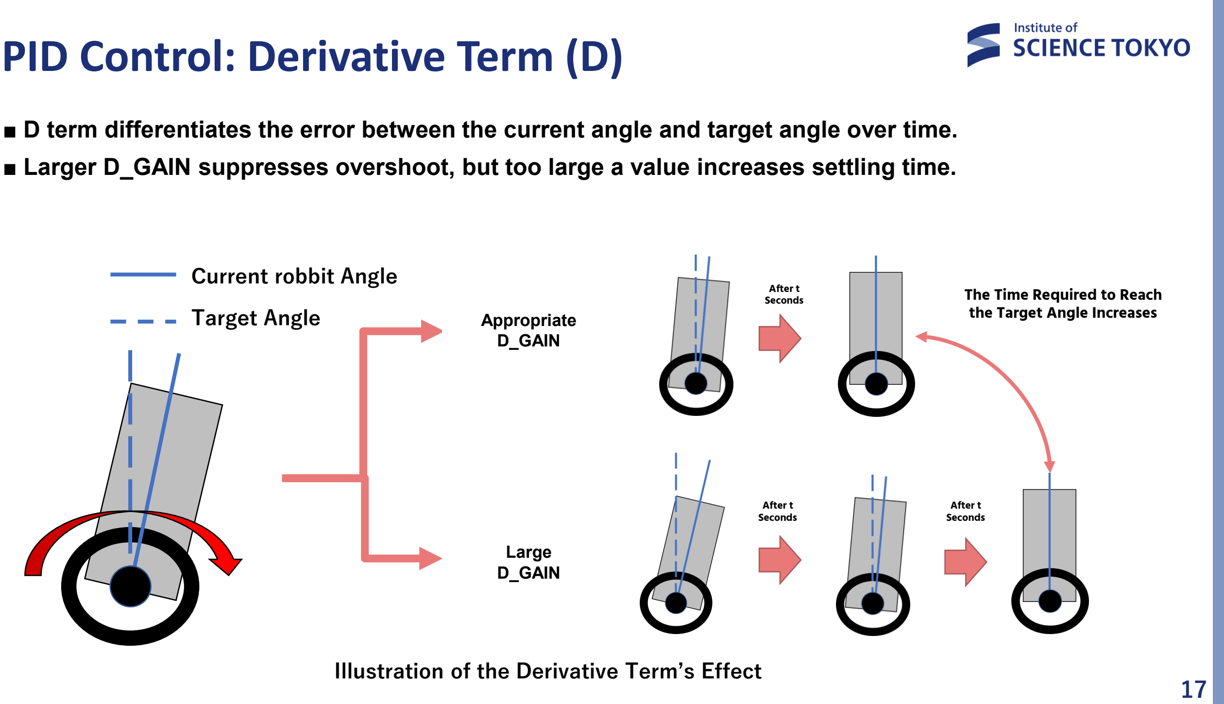
[picture p139: page 17]

17

Current robbit Angle

Target Angle

Illustration of the Derivative Term’s Effect

After t
Seconds

After t
Seconds

After t
Seconds

The Time Required to Reach the Target Angle Increases

■ D term differentiates the error between the current angle and target angle over time. ■ Larger D_GAIN suppresses overshoot, but too large a value increases settling time.

Appropriate
D_GAIN

Large
D_GAIN

## Software: PID Control

The PID controller is implemented as follows.

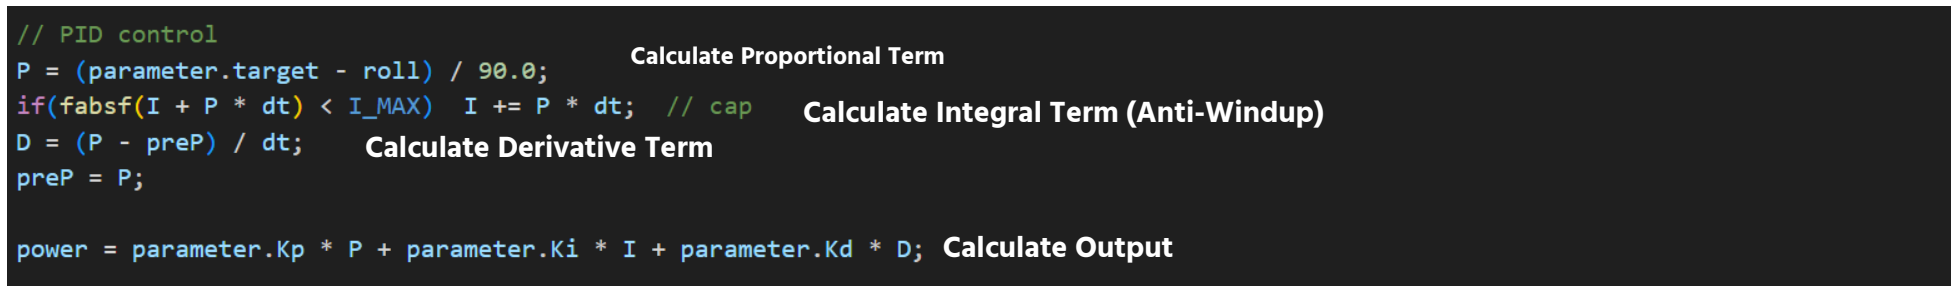
[picture p140: figure]
Calculate Proportional Term Calculate Integral Term (Anti-Windup); Calculate Derivative Term; Calculate Output

◼ P is the error between the target angle (TARGET) and current angle (roll). ◼ I integrates the proportional error using a rectangular approximation. The `if (fabsf(I + P * dt))` expression implements the anti-windup condition. ◼ D is calculated using the finite-difference derivative formula.
◼ Finally, the terms are combined in power to calculate the output.

18

## Software: Determining the PWM Signal

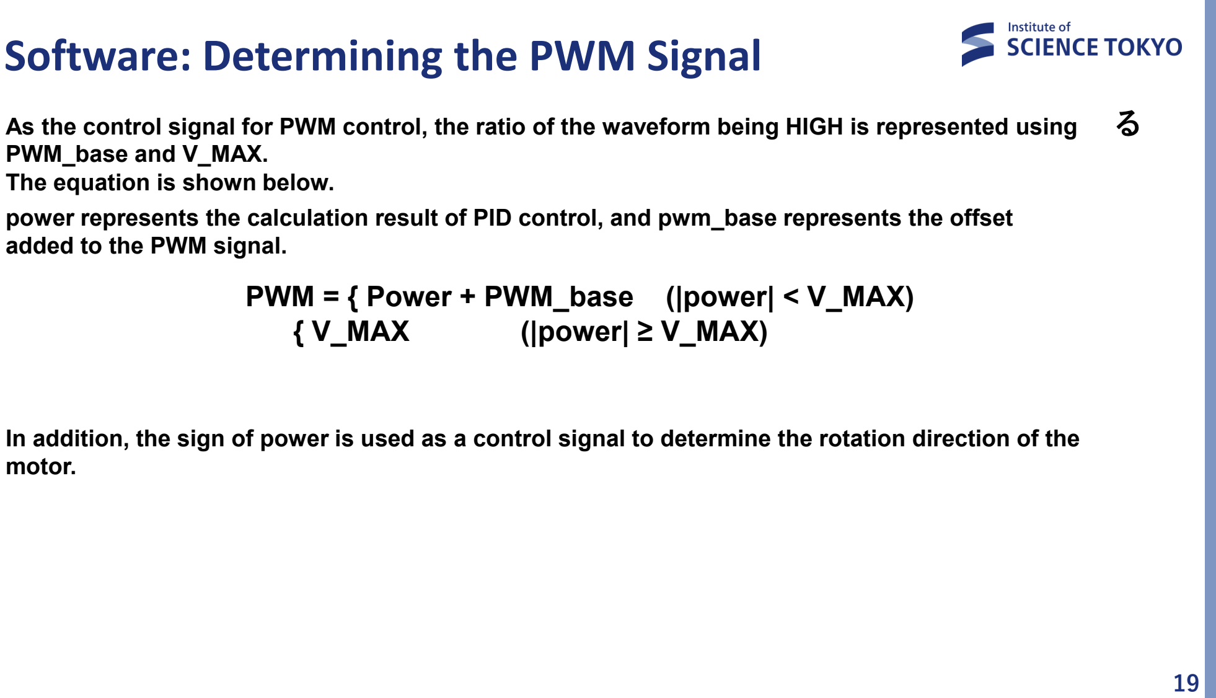
[picture p141: page 19]

19

As the control signal for PWM control, the ratio of the waveform being HIGH is represented using PWM_base and V_MAX.
The equation is shown below.
power represents the calculation result of PID control, and pwm_base represents the offset added to the PWM signal.

PWM = { Power + PWM_base (|power| < V_MAX)
{ V_MAX | (|power| ≥ V_MAX)

In addition, the sign of power is used as a control signal to determine the rotation direction of the motor.
