archlab-sciencetokyo/robbit_project/(commit log)

2025-10-31 feat: Use patches instead of sed
    [main_diff.txt, main_header_diff.txt, st7789_diff.txt]
2026-06-19 Update CFU Proving Ground submodule
2026-06-19 Update patches for CFU Proving Ground v1.8.6
