archlab-sciencetokyo/robbit_project/robbit/setting/image/display.jpg

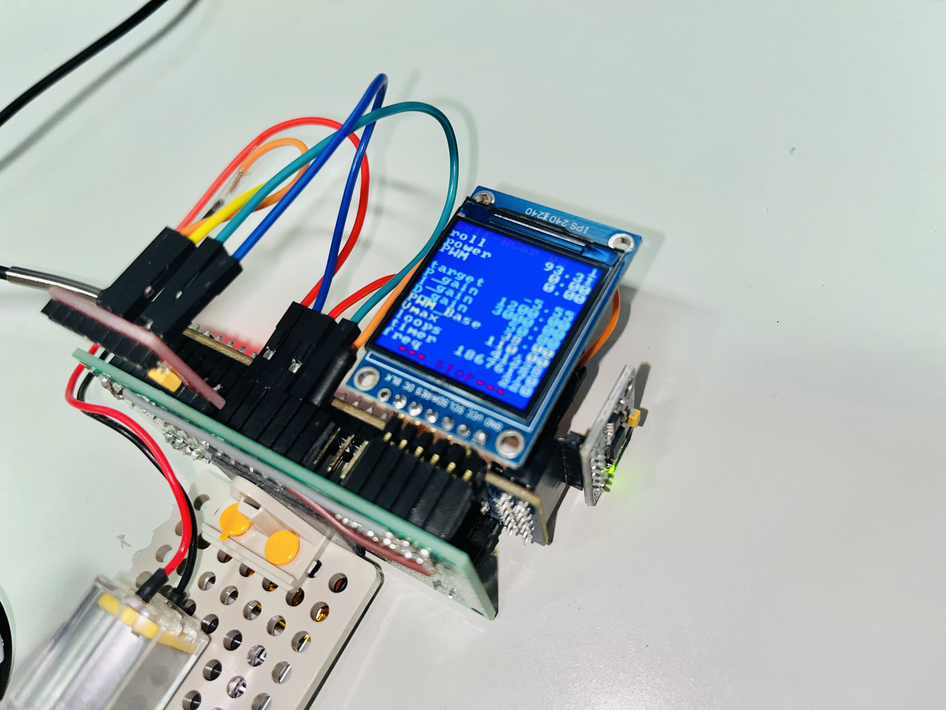
robbit/setting/image/display.jpg
